ji1udd/Hermes-Lite2/compact-trx/TX_RX_Filter/docs/filter_test_board.JPG

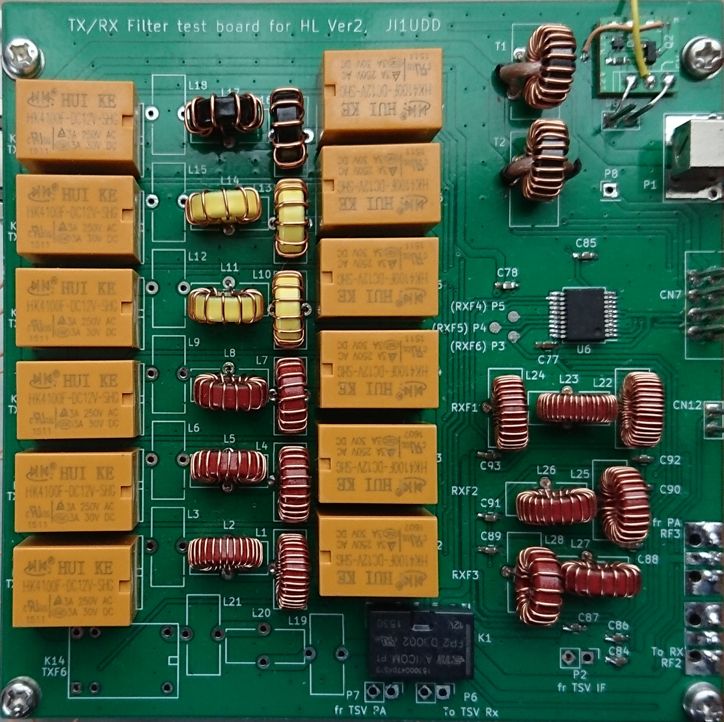
compact-trx/TX_RX_Filter/docs/filter_test_board.JPG
