ji1udd/Hermes-Lite2/compact-trx/TX_RX_Filter/docs/Filter_Setting.jpg

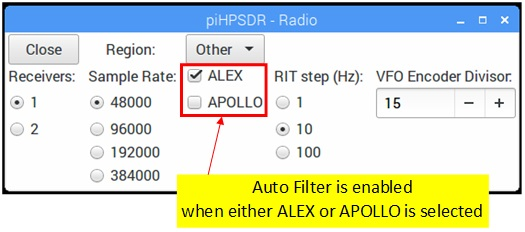
compact-trx/TX_RX_Filter/docs/Filter_Setting.jpg
