ji1udd/Hermes-Lite2/V3_Companion/V3_piHPSDR_Setting.pdf

# piHPSDR Setting

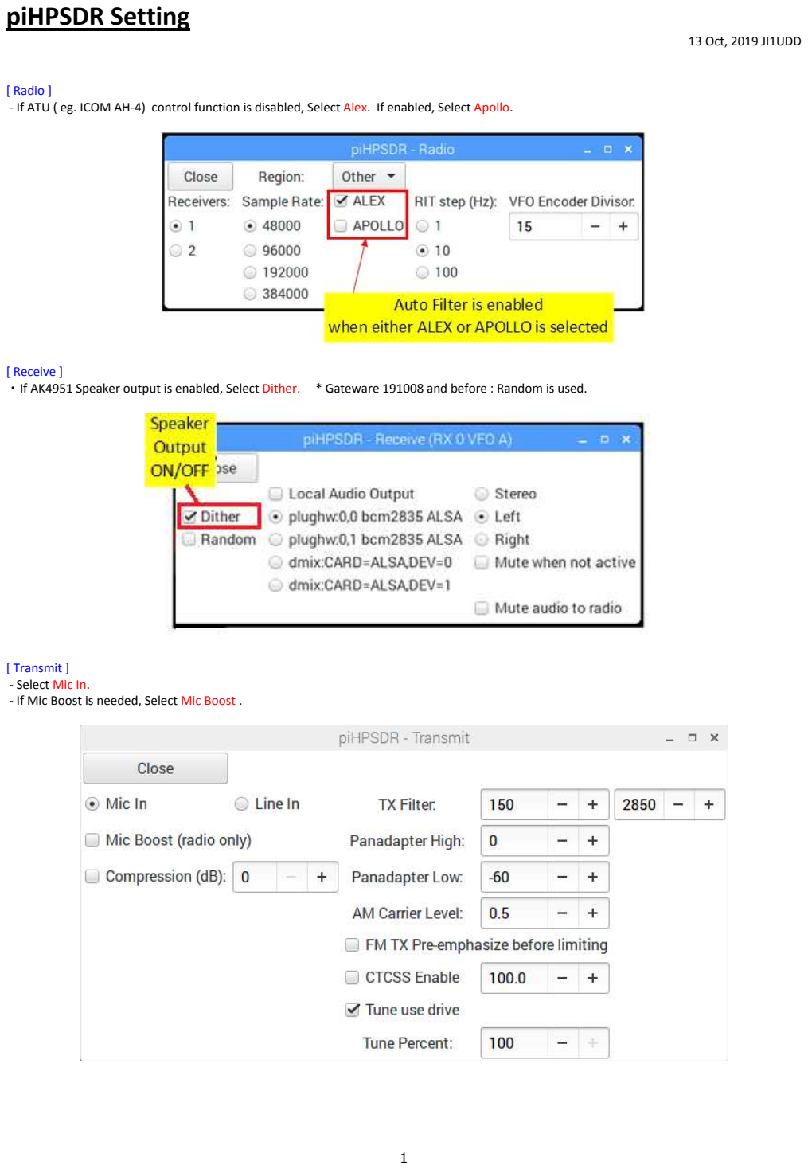
[picture p3: page 1]

### 13 Oct, 2019 JI1UDD

[ Radio ]
- If ATU ( eg. ICOM AH-4) control function is disabled, Select Alex. If enabled, Select Apollo.

[ Receive ]
・If AK4951 Speaker output is enabled, Select Dither. * Gateware 191008 and before : Random is used.

[ Transmit ]
- Select Mic In.
- If Mic Boost is needed, Select Mic Boost .

1

[ PA Calibration ]
- Set 38.8dB ( all band ).

[ CW ]

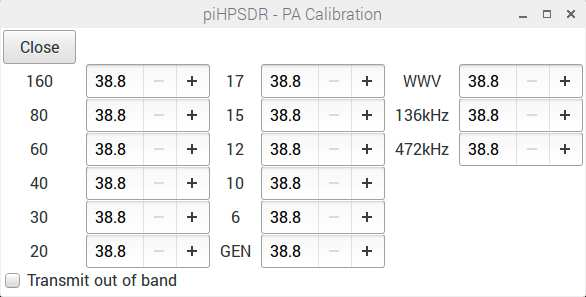
[picture p4: figure]

・Refer to https://github.com/ji1udd/Hermes-Lite/blob/6M/audiocodec/docs/Keyer_Sequece_and_setting.pdf

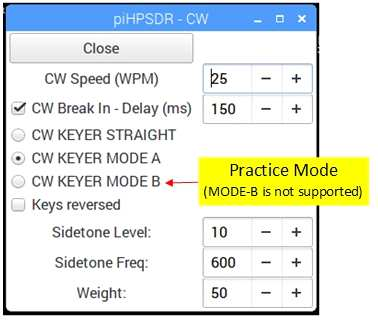
[picture p5: figure]

2

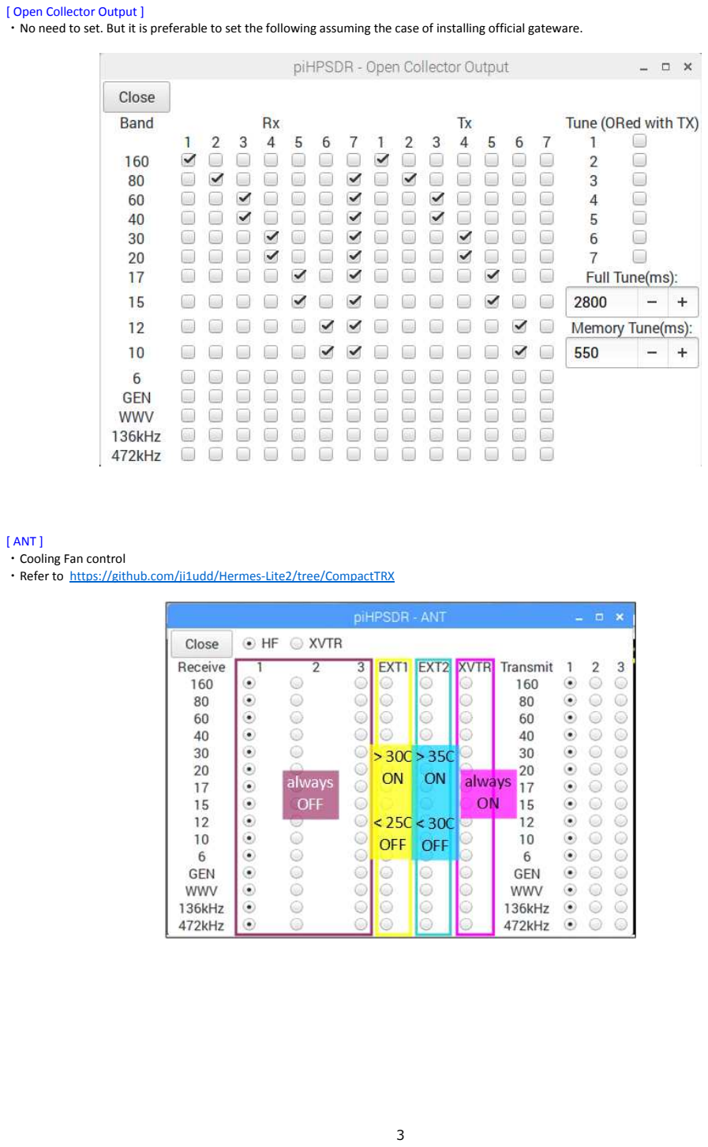
[picture p6: page 3]

[ Open Collector Output ]
・No need to set. But it is preferable to set the following assuming the case of installing official gateware.

[ ANT ]
・Cooling Fan control
・Refer to https://github.com/ji1udd/Hermes-Lite2/tree/CompactTRX

3
