ji1udd/Hermes-Lite2/V3_Companion/V3_PowerSDR_Setting.pdf

# PowerSDR Setting

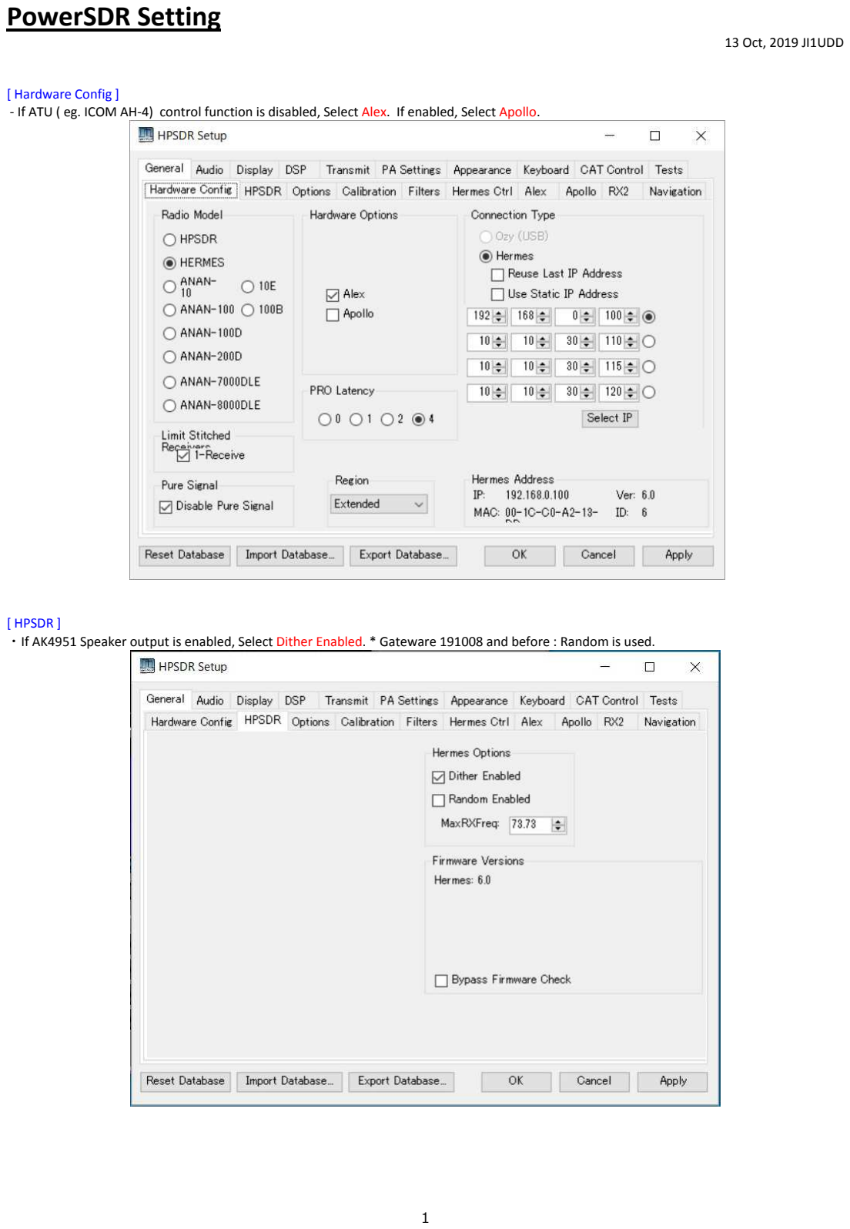
[picture p7: page 1]

### 13 Oct, 2019 JI1UDD

[ Hardware Config ]
- If ATU ( eg. ICOM AH-4) control function is disabled, Select Alex. If enabled, Select Apollo.

[ HPSDR ]
・If AK4951 Speaker output is enabled, Select Dither Enabled. * Gateware 191008 and before : Random is used.

1

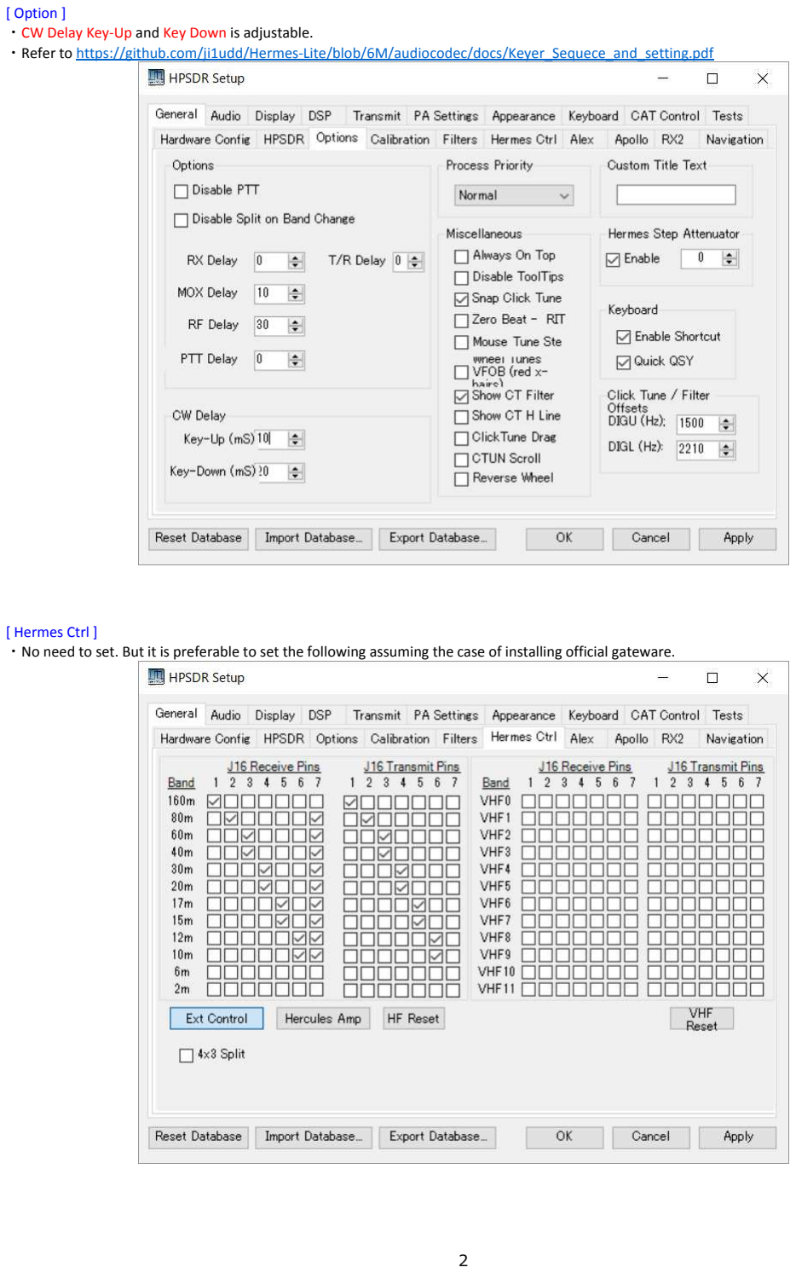
[picture p8: page 2]

[ Option ]
・CW Delay Key-Up and Key Down is adjustable.
・Refer to https://github.com/ji1udd/Hermes-Lite/blob/6M/audiocodec/docs/Keyer_Sequece_and_setting.pdf

[ Hermes Ctrl ]
・No need to set. But it is preferable to set the following assuming the case of installing official gateware.

2

[ Alex - HPF/LPF ]
・If Auto filter mode is enabled (recommended), Select Firmware.

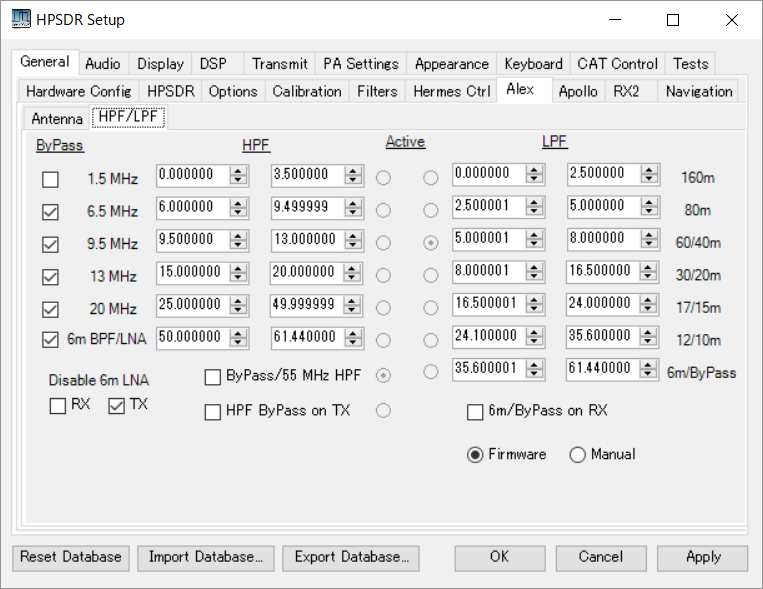
[picture p9: figure]

・If Manual filter mode is enabled, Select Manual and Set HPF and LPF freq.

3

[ Apollo ]
- If Apollo is selected on Hardware Config tab, Select Enable Filters.
- If ATU ( eg. ICOM AH-4) control function is enabled, Select Enable Tuner. Refer to https://github.com/ji1udd/Hermes-Lite2/tree/ATU

[ DSP - CW ]

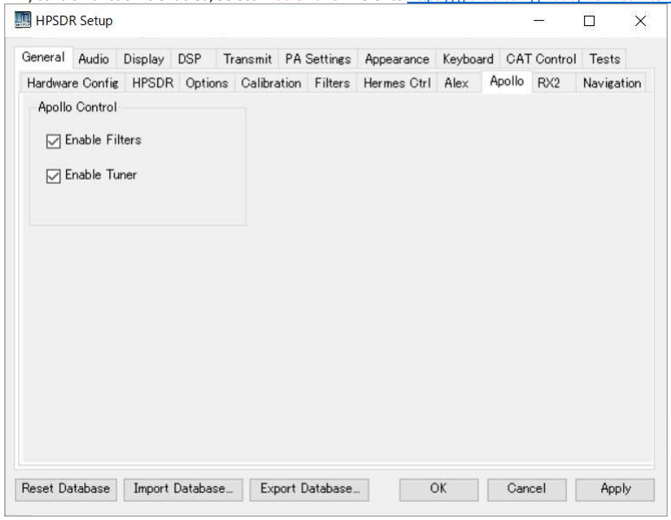
[picture p10: figure]

- Select Radio on Primary pull-down menu.
- Refer to https://github.com/ji1udd/Hermes-Lite/blob/6M/audiocodec/docs/Keyer_Sequece_and_setting.pdf

4

[ Transmit ]
- Select Mic In.
- If Mic Boost is needed, Select 20dB Mic Boost .

[ PA Settings ]

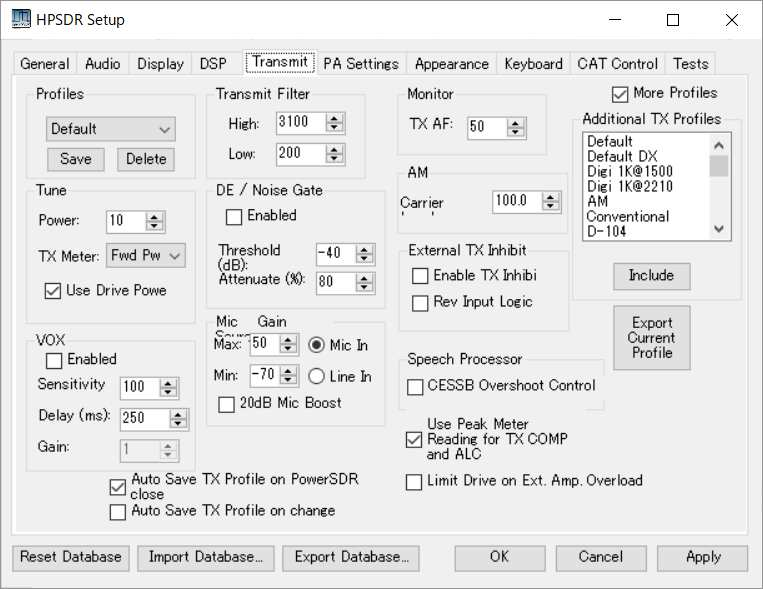
[picture p11: figure]

- Set 38.8dB ( all band ).

5
