ji1udd/Hermes-Lite2/CTRX_HL2b5/docs/HL2b5_modification_for_ComboBoard.pdf

18 Mar. 2018 JI1UDD
1. For Power Supply control

1-1. Remove J24 to enable to be controlled by PIC12F1822. Note: If forget this, PIC will be broken soon.

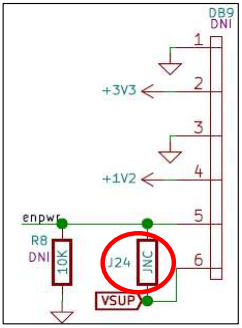
[picture p12: figure]
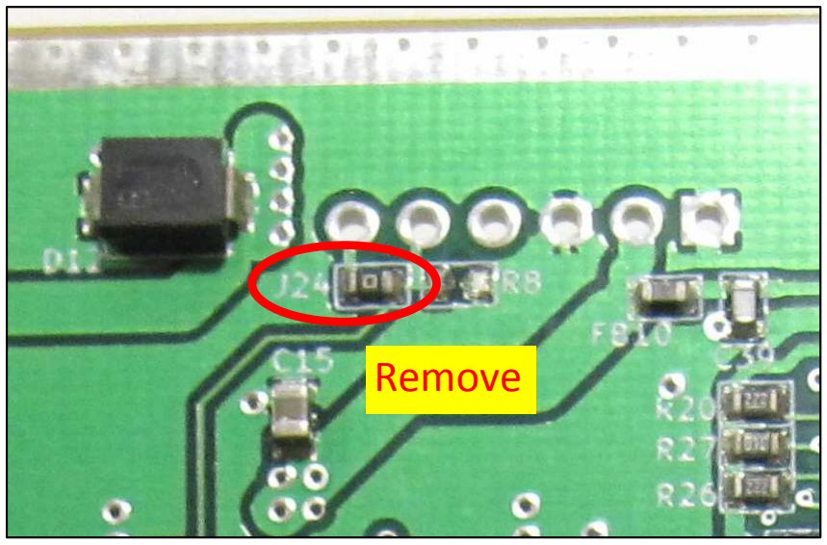
[picture p13: figure]
Remove

1-2. Install R9 to disable VPA reliably during power off.

# HL2b5 Modification for Combo board

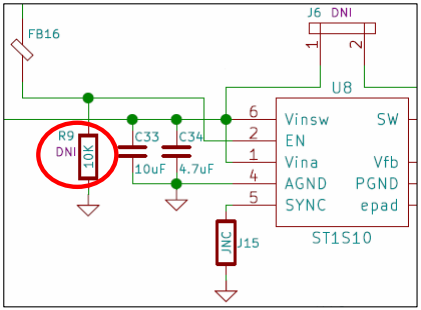
[picture p14: figure]
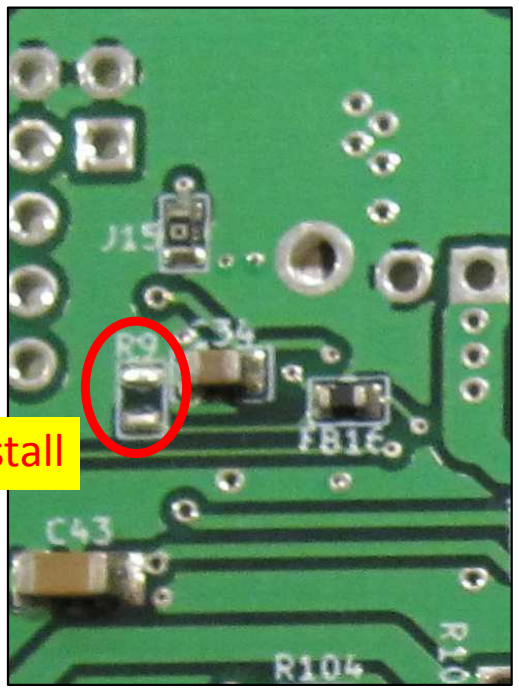
[picture p15: figure]

Install

2. For Audio Codec

Supply 3.3V to VLVDS (AK4951 IO power supply) instead of 2.5V.
2-1. Remove FB28
2-2. Install the removed Ferrite Bead between DB1-7pin and R72 (3.3V side).

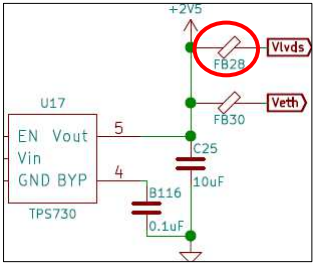
[picture p16: figure]
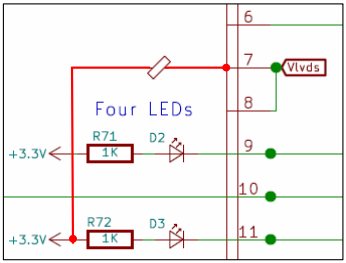
[picture p17: figure]
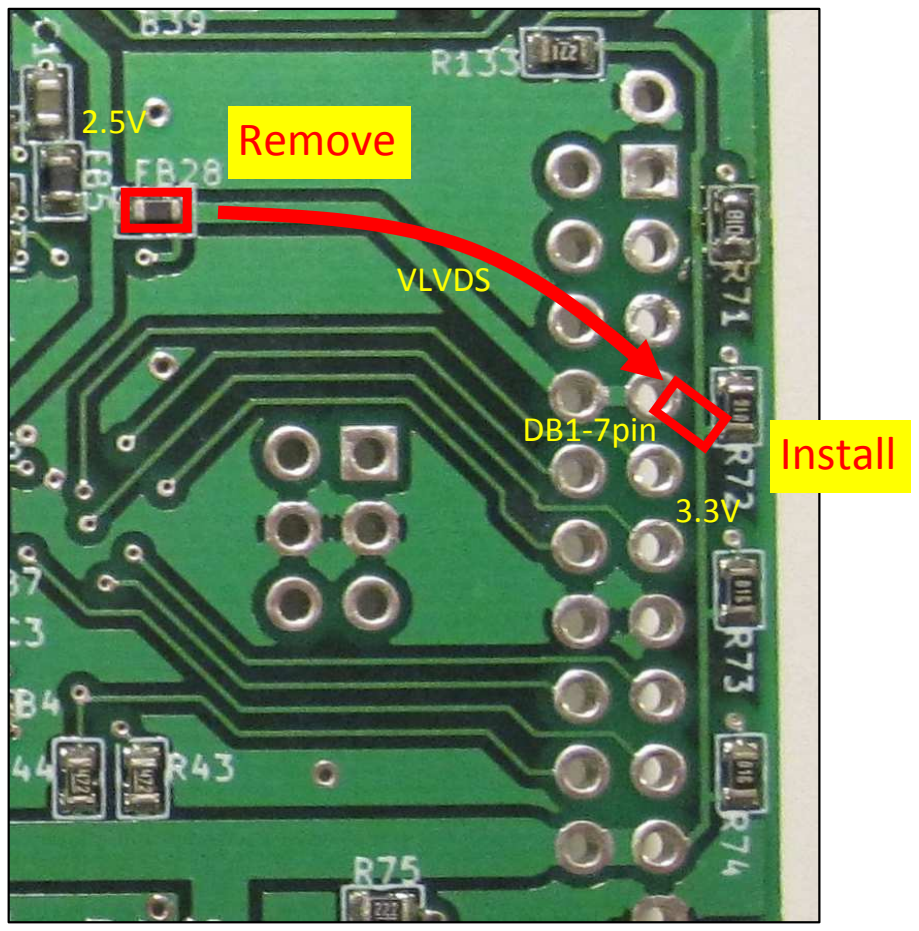
[picture p18: figure]
Remove; Install; VLVDS; DB1-7pin

Appendix

- Install R117, R118 and R119 to disable the function reliably

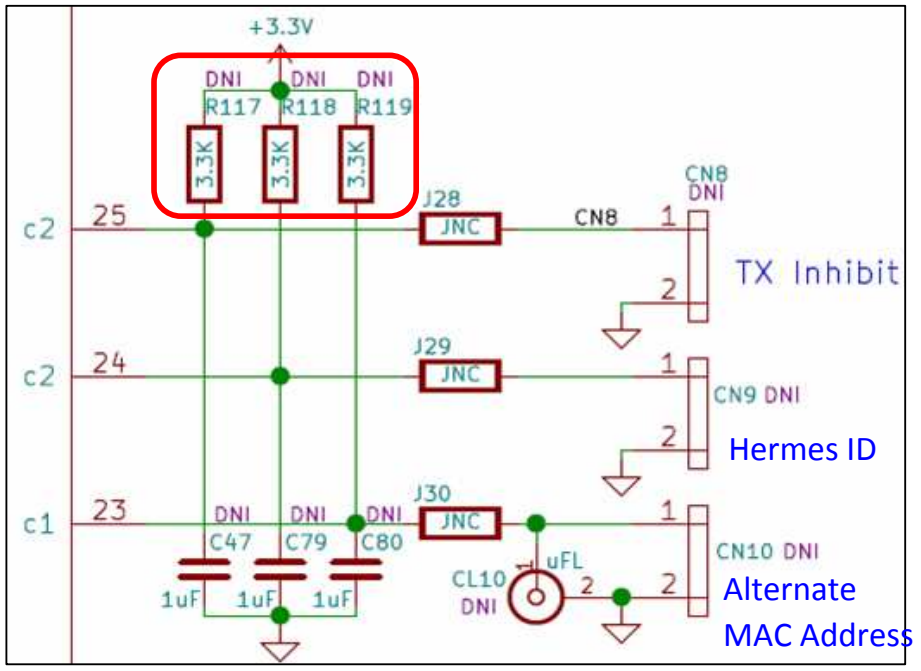
[picture p19: figure]
Hermes ID; Alternate; MAC Address
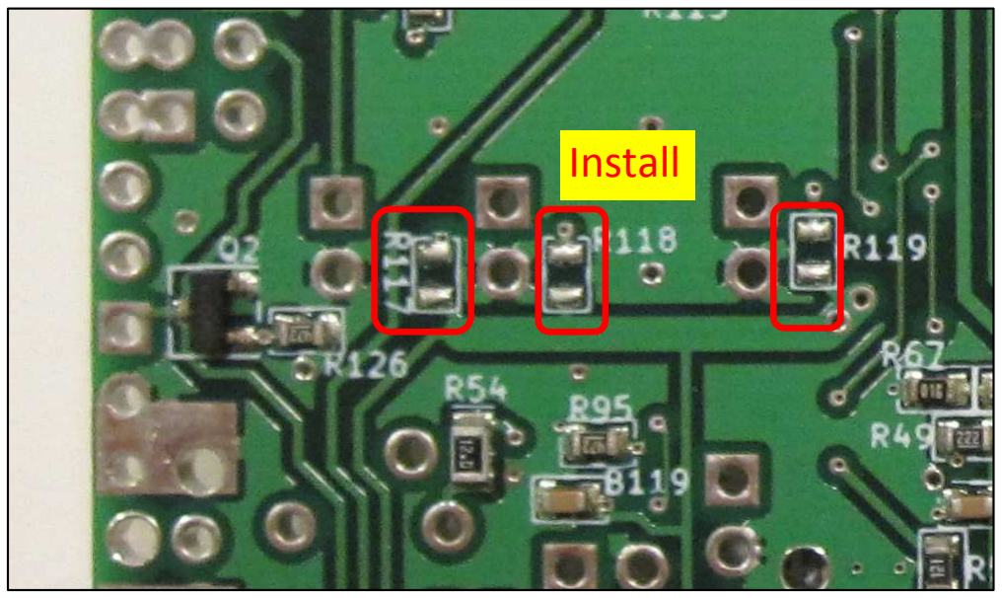
[picture p20: figure]
Install
