ji1udd/Hermes-Lite2/compact-trx/piHPSDR/docs/Temperature_Ammeter_Mod_171217.pdf

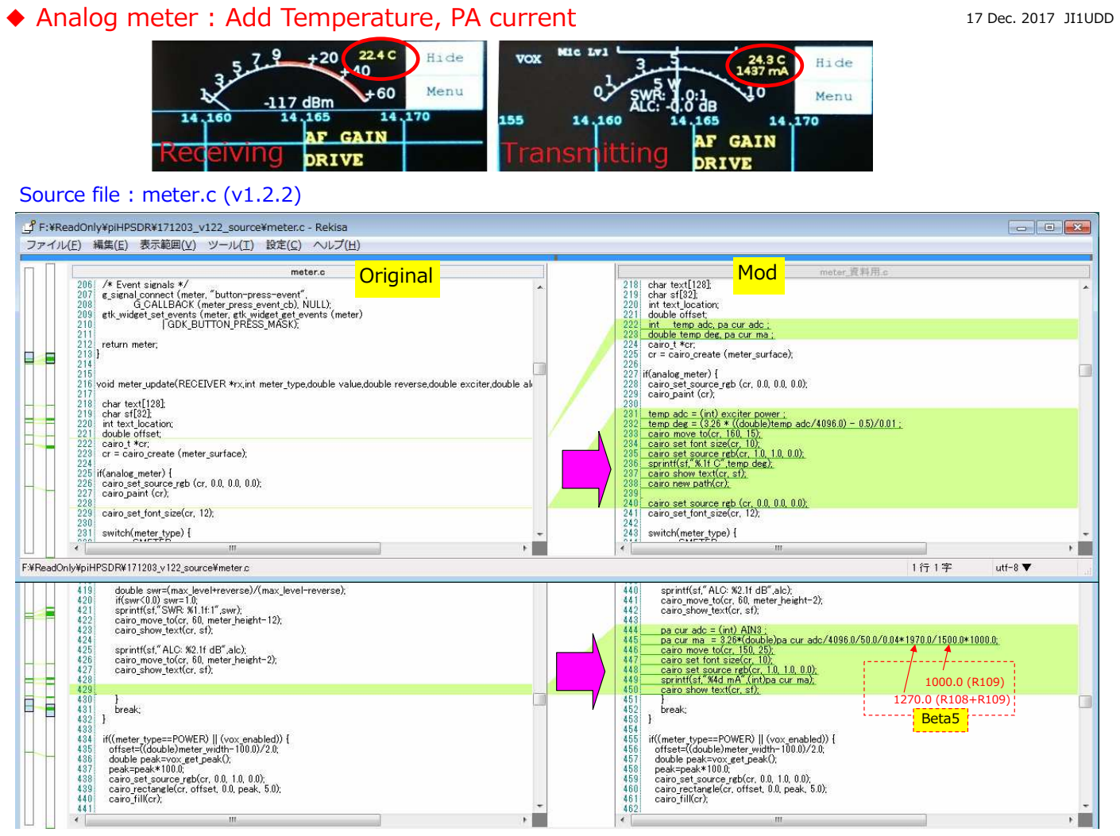
[picture p21: page 1]

◆ Analog meter : Add Temperature, PA current | 17 Dec. 2017 JI1UDD

Source file : meter.c (v1.2.2)

Original | Mod

1000.0 (R109)
1270.0 (R108+R109)
Beta5
