ji1udd/Hermes-Lite2/compact-trx/piHPSDR/docs/FWD_Analog_Meter_Mod_171210.pdf

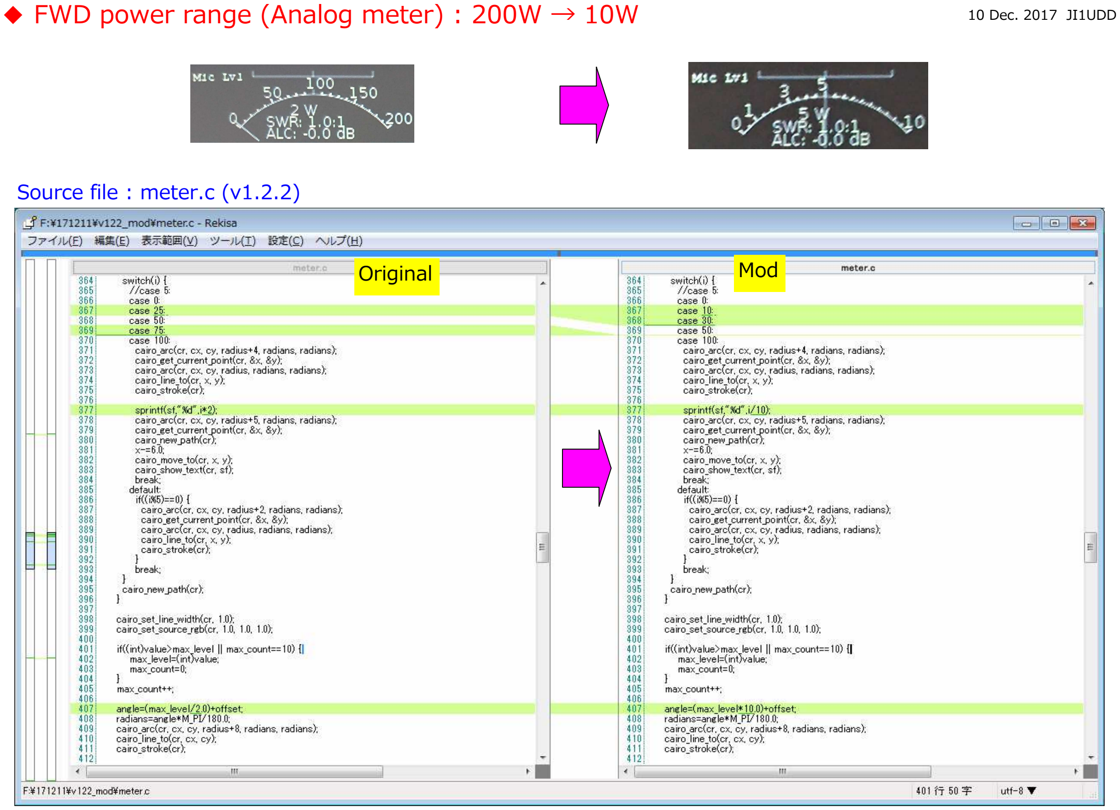
[picture p22: page 1]

◆ FWD power range (Analog meter) : 200W → 10W | 10 Dec. 2017 JI1UDD

Source file : meter.c (v1.2.2)

Original | Mod
