ji1udd/Hermes-Lite2/compact-trx/piHPSDR/docs/Slider_RxGAIN_Mod_171210.pdf

◆ Slider function : Attenuator → RX GAIN | 10 Dec. 2017 JI1UDD

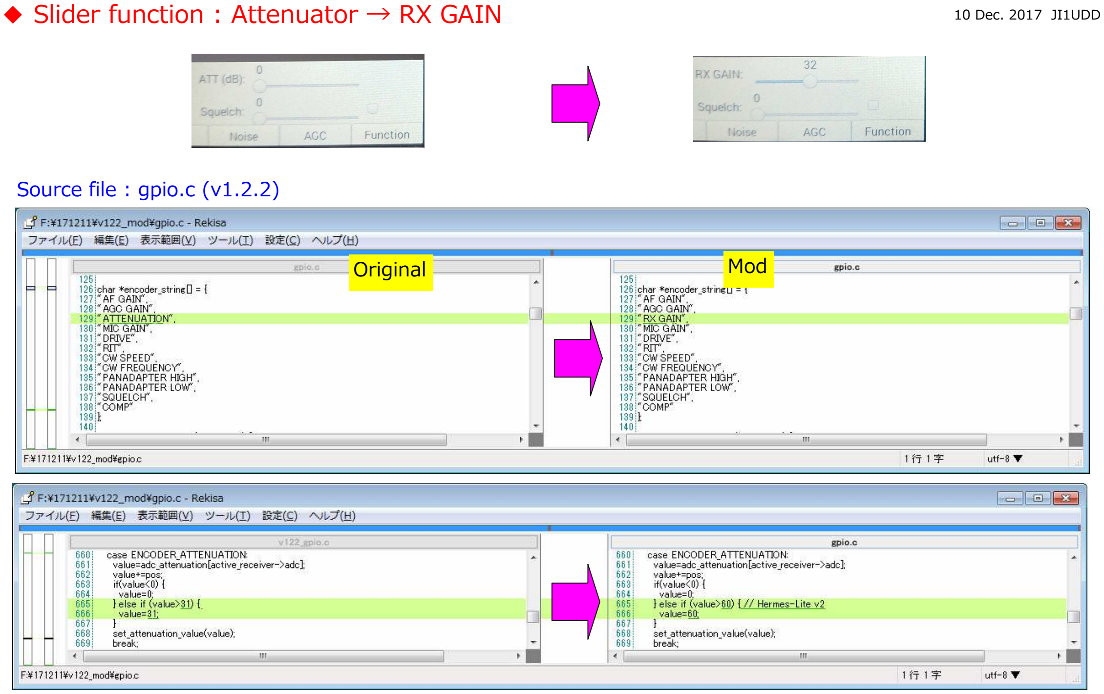
[picture p23: page 1]

Source file : gpio.c (v1.2.2)

Original | Mod

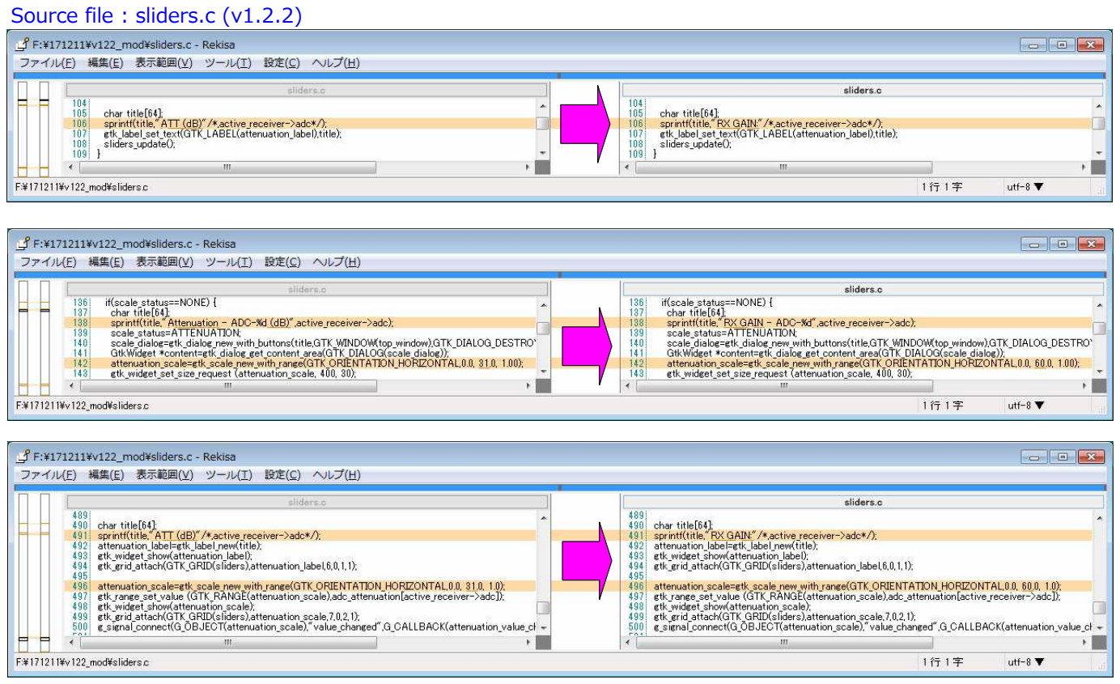
[picture p24: page 2]

Source file : sliders.c (v1.2.2)

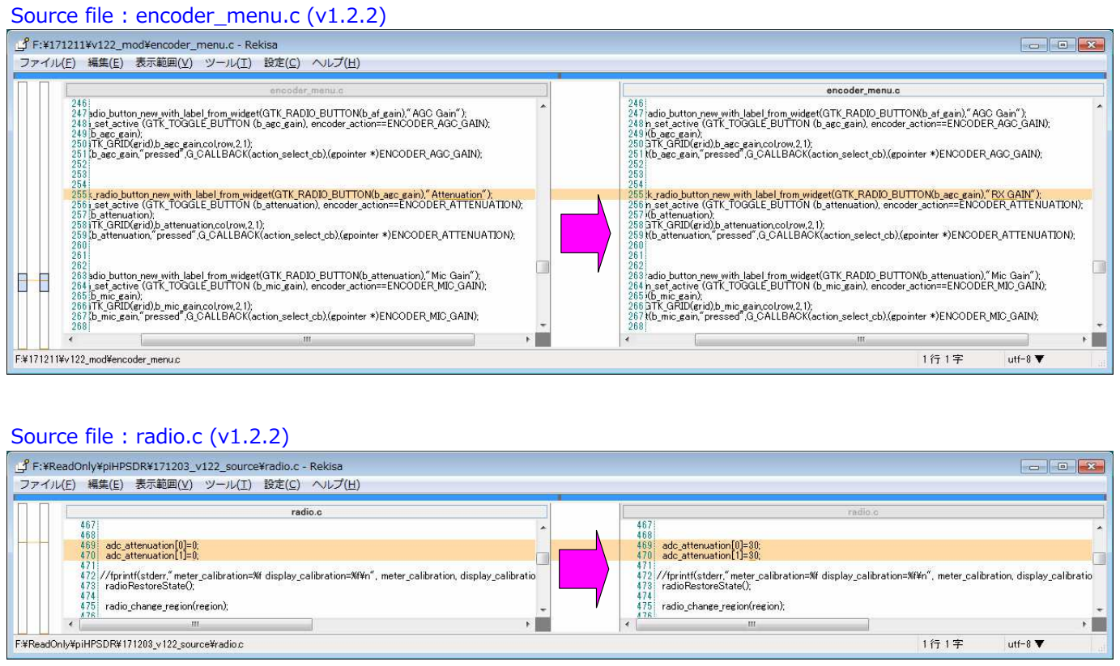
[picture p25: page 3]

Source file : encoder_menu.c (v1.2.2)

Source file : radio.c (v1.2.2)

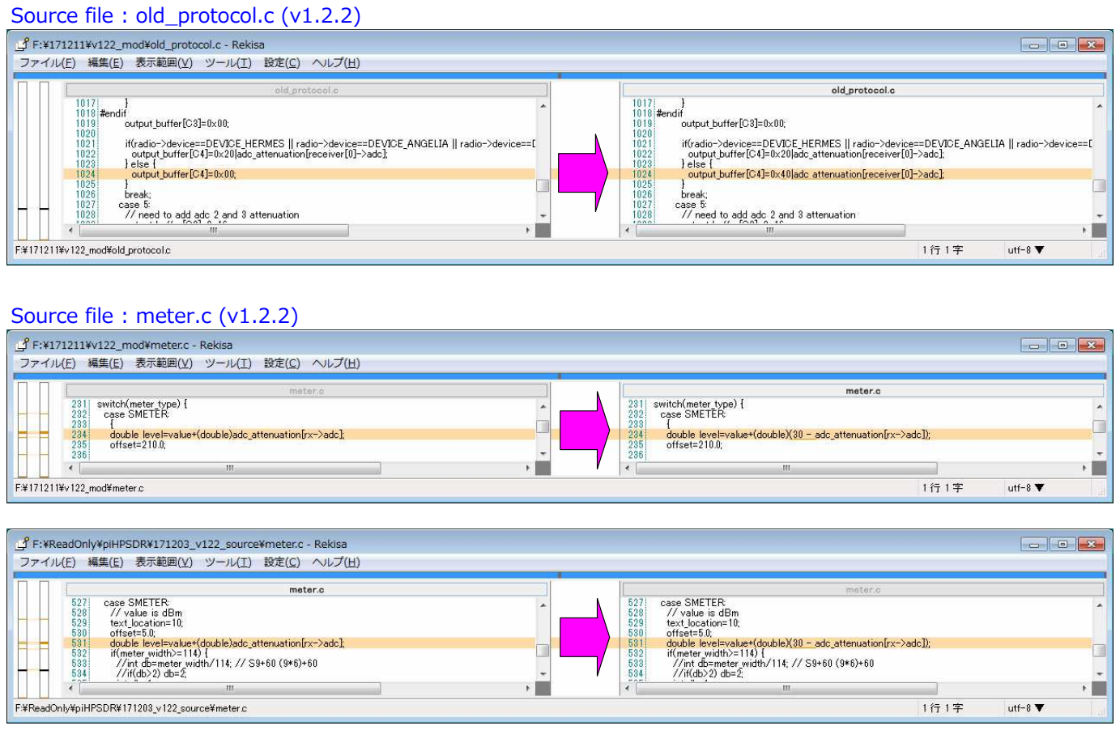
[picture p26: page 4]

Source file : old_protocol.c (v1.2.2)

Source file : meter.c (v1.2.2)

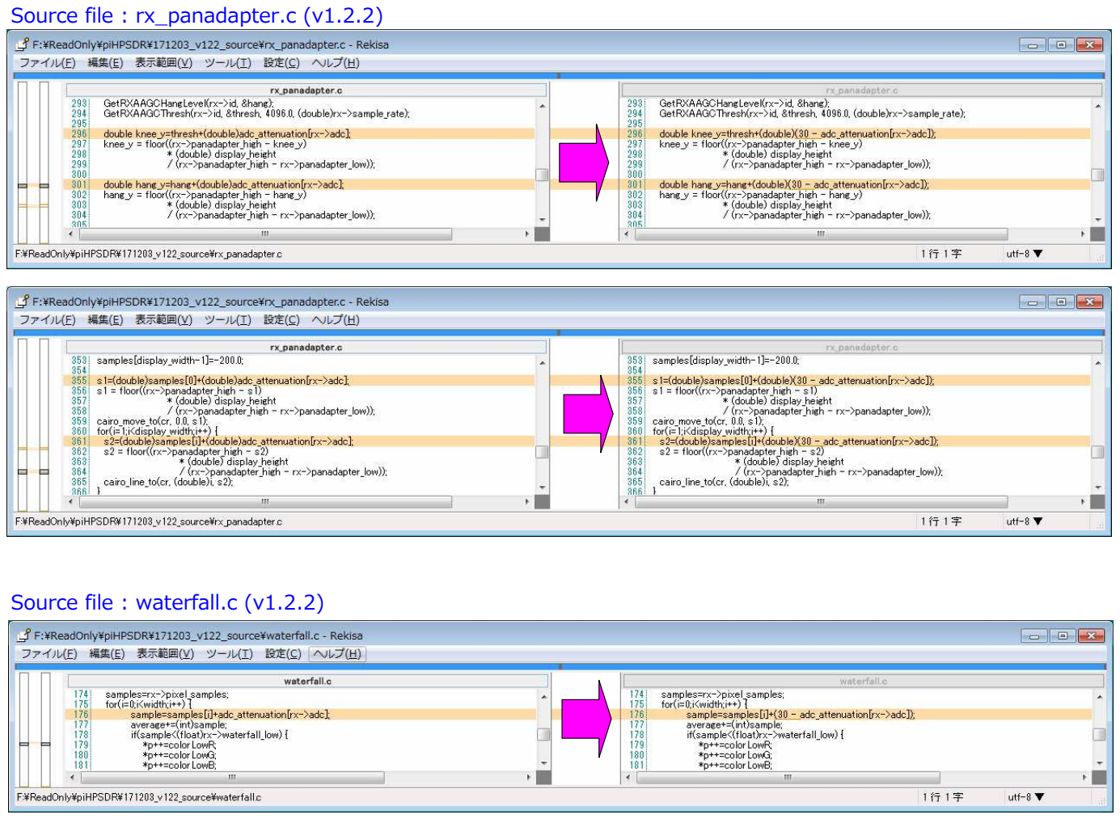
[picture p27: page 5]

Source file : rx_panadapter.c (v1.2.2)

Source file : waterfall.c (v1.2.2)
