ji1udd/Hermes-Lite2/compact-trx/IF_board/docs/IF_board.JPG

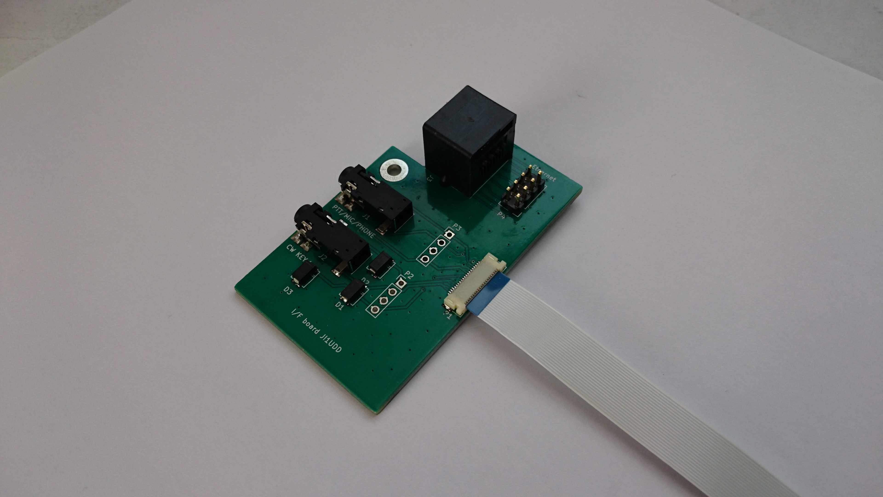
compact-trx/IF_board/docs/IF_board.JPG
