ji1udd/Hermes-Lite2/compact-trx/Keyer_AK4951/docs/Headset_modification.jpg

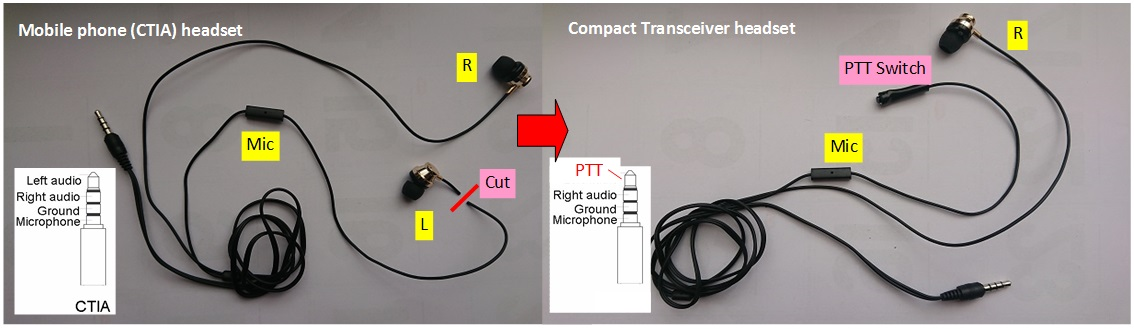
compact-trx/Keyer_AK4951/docs/Headset_modification.jpg
