ji1udd/Hermes-Lite2/compact-trx/Keyer_AK4951/docs/HLv2Beta3_with_KeyerIF_AK4951_board.JPG

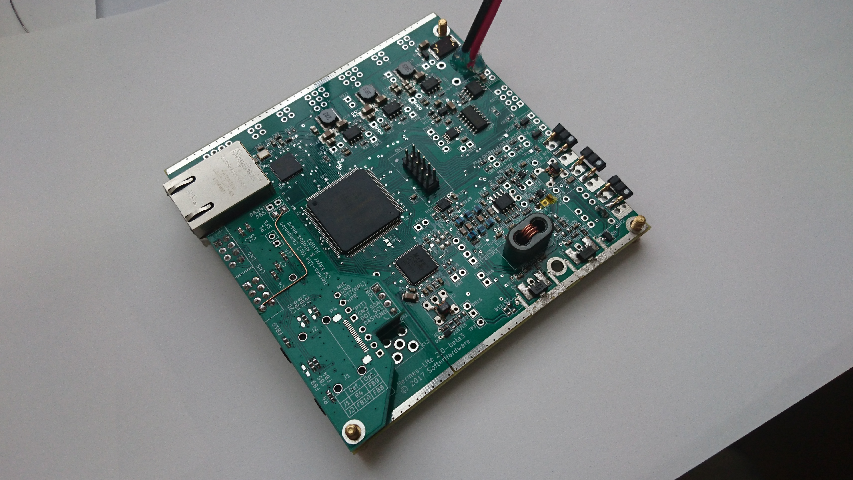
compact-trx/Keyer_AK4951/docs/HLv2Beta3_with_KeyerIF_AK4951_board.JPG
