ji1udd/Hermes-Lite2/compact-trx/Keyer_AK4951/docs/Speaker_Setting.jpg

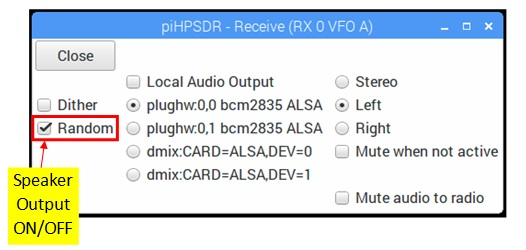
compact-trx/Keyer_AK4951/docs/Speaker_Setting.jpg
