ji1udd/Hermes-Lite2/compact-trx/piHPSDR/docs/FWD_meter_mod.jpg

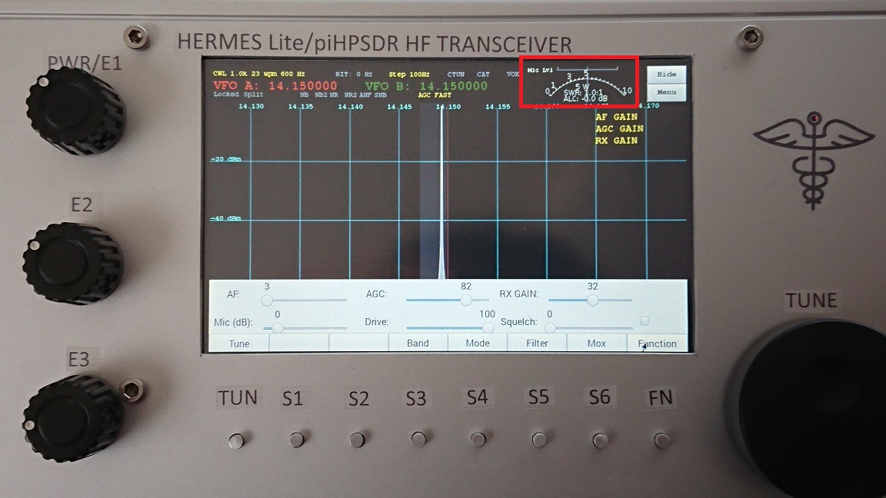
compact-trx/piHPSDR/docs/FWD_meter_mod.jpg
