ji1udd/Hermes-Lite2/compact-trx/piHPSDR/docs/RX_GAIN_mod.jpg

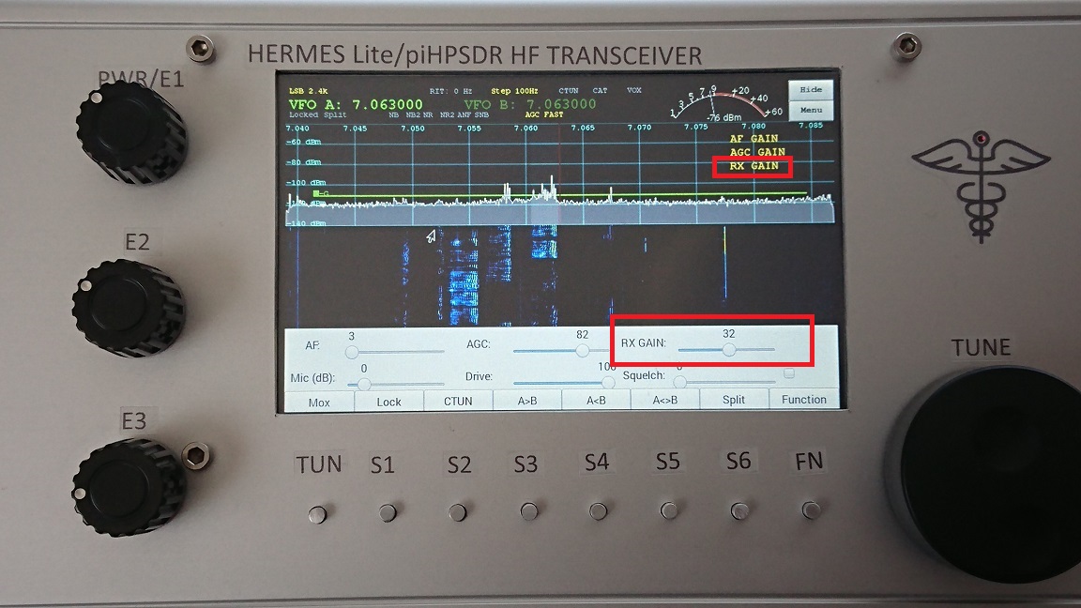
compact-trx/piHPSDR/docs/RX_GAIN_mod.jpg
