ji1udd/Hermes-Lite2/compact-trx/piHPSDR/docs/Temperature_Ammeter_Mod.jpg

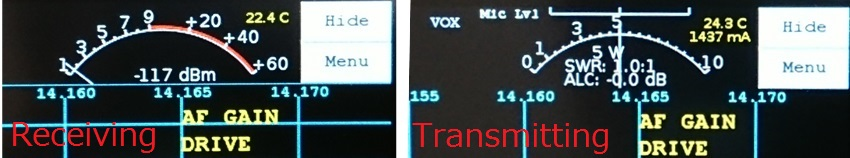
compact-trx/piHPSDR/docs/Temperature_Ammeter_Mod.jpg
