ji1udd/Hermes-Lite2/compact-trx/powercontrol/docs/Add-on-PMOS-switch.png

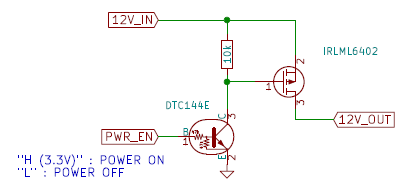
compact-trx/powercontrol/docs/Add-on-PMOS-switch.png
