ji1udd/Hermes-Lite2/compact-trx/powercontrol/docs/ATU_Setting.jpg

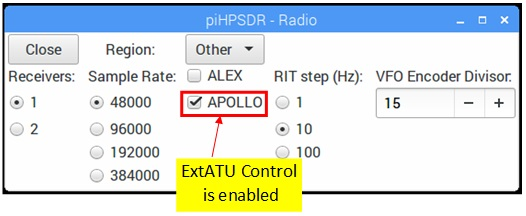
compact-trx/powercontrol/docs/ATU_Setting.jpg
