ji1udd/Hermes-Lite2/compact-trx/powercontrol/docs/ATU_timing_chart.jpg

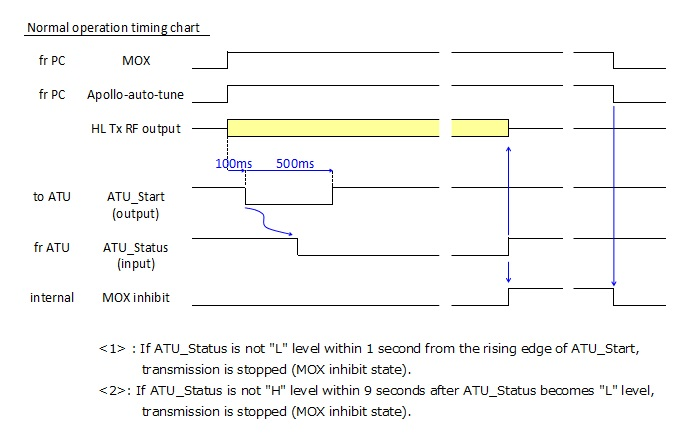
compact-trx/powercontrol/docs/ATU_timing_chart.jpg
