ji1udd/Hermes-Lite2/compact-trx/powercontrol/docs/compact-trx-photos.jpg

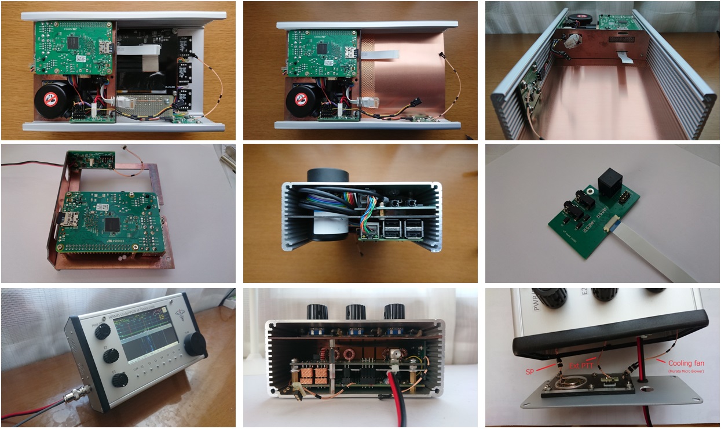
compact-trx/powercontrol/docs/compact-trx-photos.jpg
