ji1udd/Hermes-Lite2/compact-trx/powercontrol/docs/compact-trx.JPG

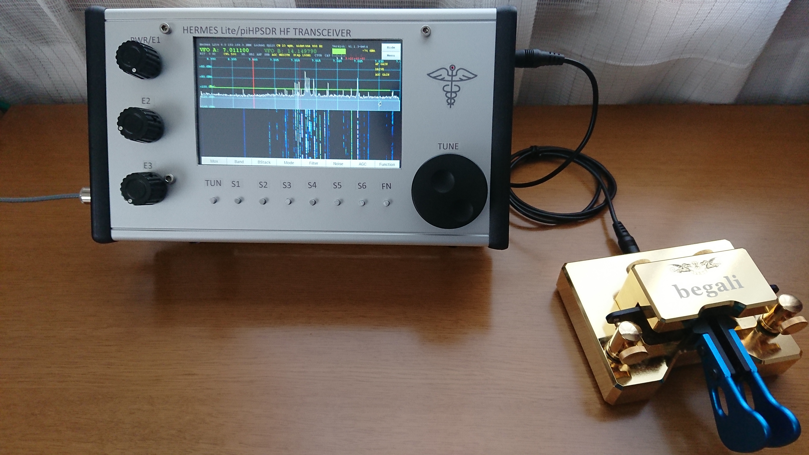
compact-trx/powercontrol/docs/compact-trx.JPG
