ji1udd/Hermes-Lite2/compact-trx/powercontrol/docs/ExtAMP-ATU-Interface.jpg

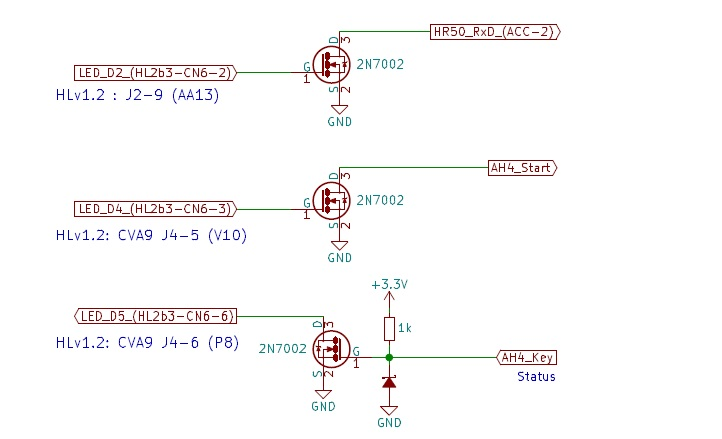
compact-trx/powercontrol/docs/ExtAMP-ATU-Interface.jpg
