ji1udd/Hermes-Lite2/compact-trx/powercontrol/docs/Fan_Control_setting.jpg

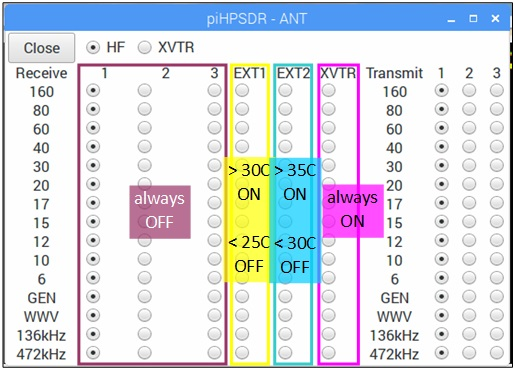
compact-trx/powercontrol/docs/Fan_Control_setting.jpg
