ji1udd/Hermes-Lite2/compact-trx/powercontrol/docs/PowerControlboard.jpg

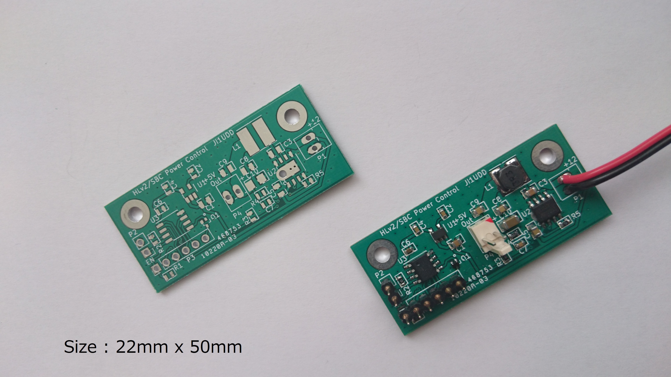
compact-trx/powercontrol/docs/PowerControlboard.jpg
