ji1udd/Hermes-Lite2/CTRX_HL2b5/docs/LEDs_function.jpg

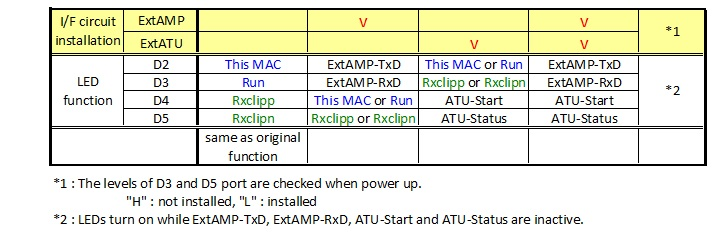
CTRX_HL2b5/docs/LEDs_function.jpg
