ji1udd/Hermes-Lite2/compact-trx/IF_board/docs/BOM_IF_board.pdf

Designator | Qty. | Value/Description | Package | Manufacture | Manufacturer P/N | Supplier | Supplier P/N
D1, D2, D3 | 3 | TVS Diode
J1, J2 | 2 | 3.5mm Jack 4-contact | - | CUI | SJ-43514-SMT
J3 | 1 | RJ45 | - | WURTH
P1 | 1 | CONN FFC 20POS 0.50MM R/A Non-ZIF | - | Kyocera/AVX | 6222Series 086222020101800+ | DigiKey | 1253-1779-1-ND
P2, P3 | 2 | Pin header 2.54mm 4pin | -
Designator | Qty. | Value/Description | Package | Manufacture | Manufacturer P/N | Supplier | Supplier P/N
- | 1 | CABLE FFC 20POS 0.50MM 4" | - | Molex | 151660211 | DigiKey | WM11307-ND
