ji1udd/Hermes-Lite2/CTRX_HL2b5/docs/IF_board_assemble_option.pdf

Assembly options
option # | I/F board | Cable type | Audio codec board | IF board
Install | Don't care (not used) | Install | Don't care (not used)
1 | No use | - | J1, J2 | P2, P3, P4 | - | -
2 | Use | Shielded cable | P2, P3 | J1, J2, P4 | J1, J2, P2, P3 | P1
3 | Use | FFC | P4 | J1, J2, P2, P3 | J1, J2, P1 | P2, P3
