ji1udd/Hermes-Lite2/CTRX_HL2b5/docs/Installation_Guide_codec_HL2b5_or_later.pdf

### Installation guide "CW Keyer I/F and AK4951 audio codec board" for HL2b5 or later

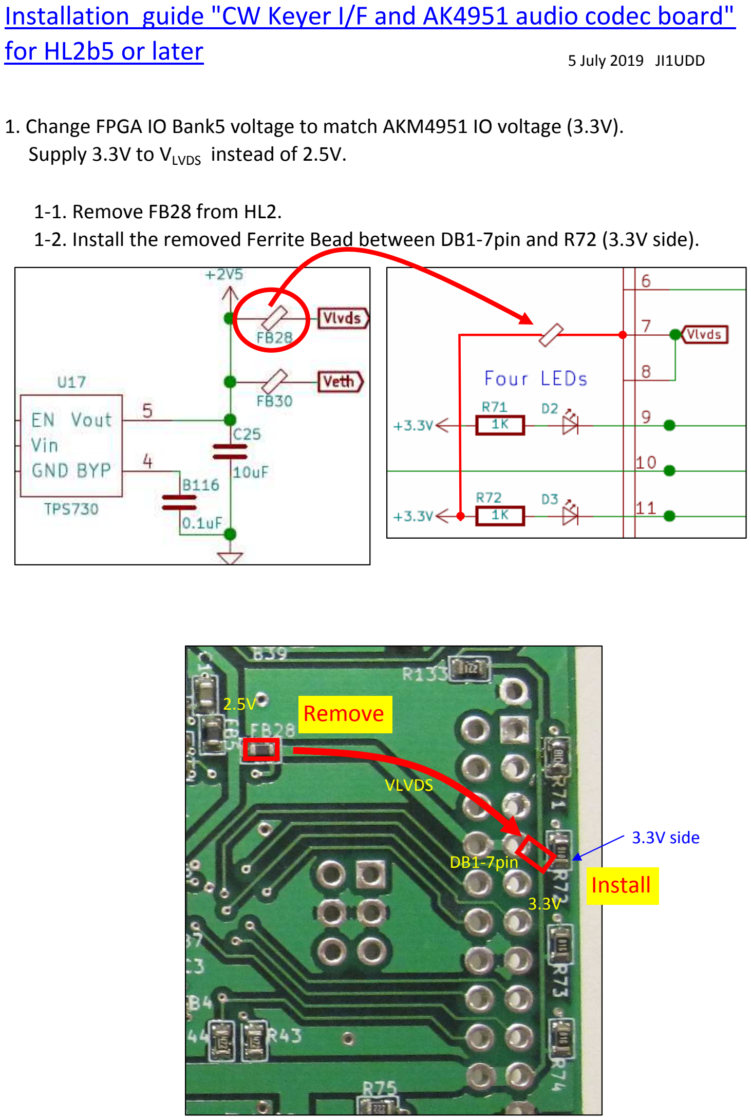
[picture p48: page 1]

### 5 July 2019 JI1UDD

1. Change FPGA IO Bank5 voltage to match AKM4951 IO voltage (3.3V). Supply 3.3V to VLVDS instead of 2.5V.

1-1. Remove FB28 from HL2.
1-2. Install the removed Ferrite Bead between DB1-7pin and R72 (3.3V side).

Remove

Install

VLVDS

2.5V

3.3V

DB1-7pin

3.3V side

2. Connect "CW Keyer I/F and AK4951 audio codec board" to HL2.

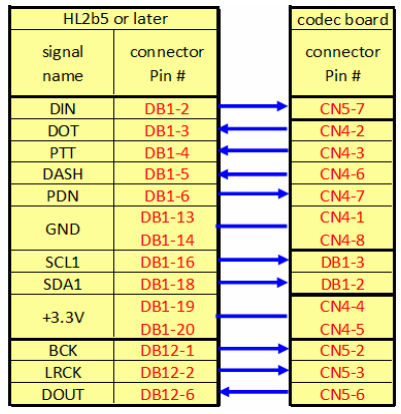
[picture p49: figure]
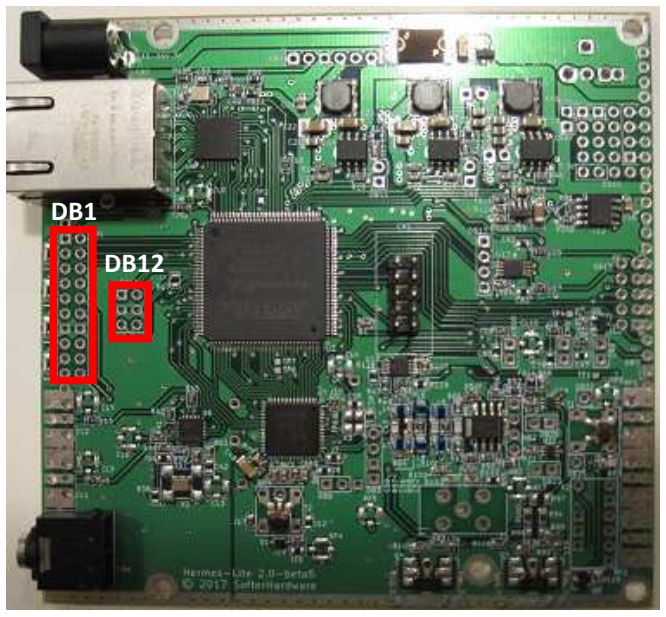
[picture p50: figure]
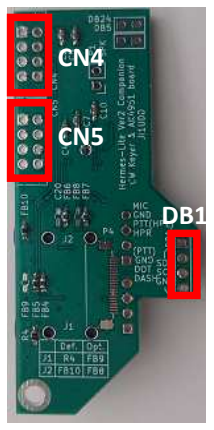
[picture p51: figure]
