ji1udd/Hermes-Lite2/compact-trx/Keyer_AK4951/docs/KeyerIF_AK4951_v2.0.1_PCB_Installation_guide.pdf

Keyer I/F ＆ AK4951 v2.0.1 Installation guide | 17th Aug, 2017 ji1udd

Please read Errata document and do counter measure.

HLv2 modification
1. Remove FB28 and install FB27 ( Vlvds is set to 3.3V ).
2. Remove J14 and install J13 ( CN4-3 and CN4-4 are set to Vlvds).
3. install three 0 ohm resistors at R85, R86 and R87 ( I2S signals are connect to AK4951).

Note
When connectors are assembled, be care of placement torrerance.

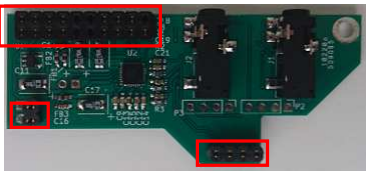
[picture p52: figure]
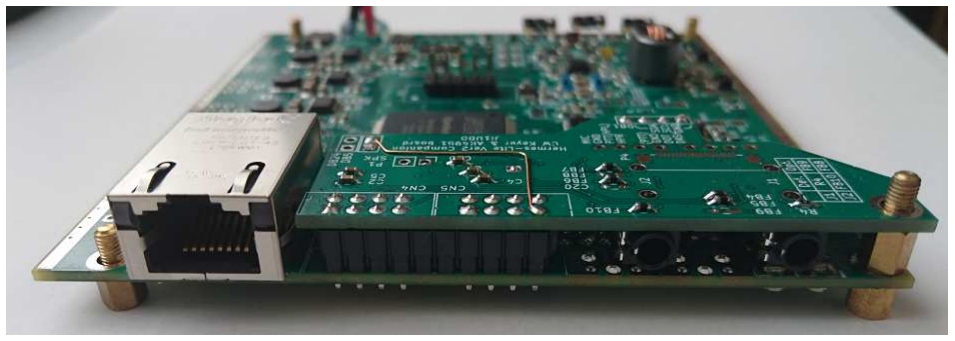
[picture p53: figure]
