ji1udd/Hermes-Lite2/CTRX_HL2b5/docs/PowerSDR_ALEX_ManualFilter_setting_for_Jims_Filter.jpg

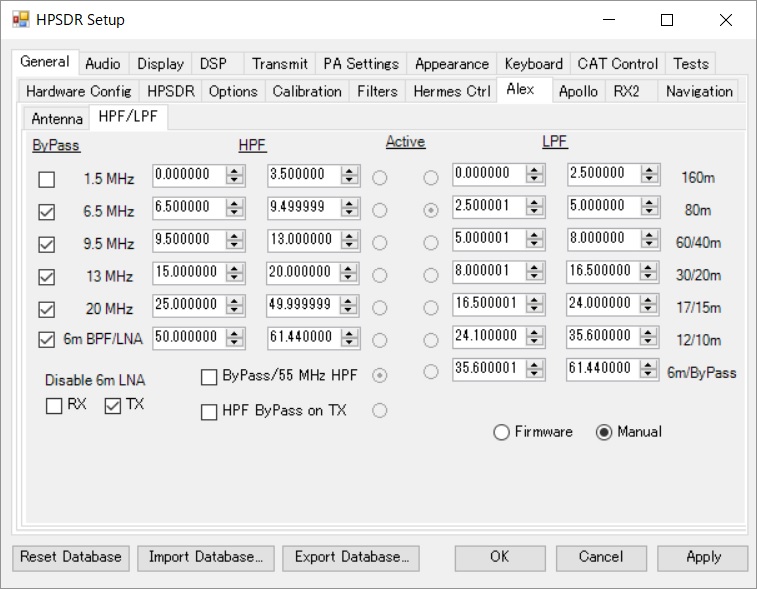
CTRX_HL2b5/docs/PowerSDR_ALEX_ManualFilter_setting_for_Jims_Filter.jpg
