ji1udd/Hermes-Lite2/CTRX_HL2b5/docs/ComboBoardErrata_180406.pdf

### 6 Apr. 2018 JI1UDD

- Wrong MCP23008 footprint

SSOP-20 version is used on Combo board schematic. But SOIC-20 footprint is used on PCB. MCP23008 SOIC-20 is not in the lineup, but SOIC-18 is in the lineup.
Use MCP23008-E/SO (SOIC-18), place it close to the 1pin side.

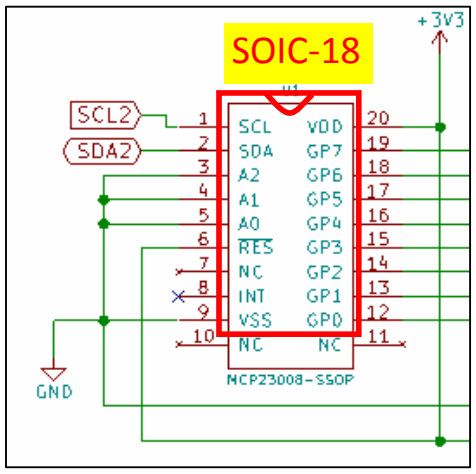
[picture p55: figure]
SOIC-18
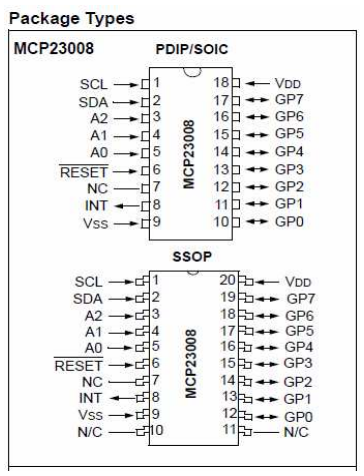
[picture p56: figure]

cf.

# Combo board errata

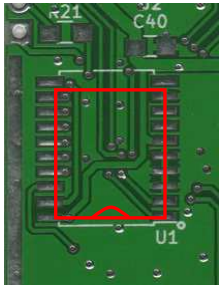
[picture p57: figure]
