ji1udd/Hermes-Lite2/compact-trx/TX_RX_Filter/docs/Tx_Rx_Filter_v1.0_PCB_Errata.pdf

Tx Rx Filter v1.0 PCB Errata | 17th Aug, 2017
| 18th Oct, 2017
There is two known errata. | ji1udd
1) Wrong Silk
The silks near RF2 and RF3 are swapped

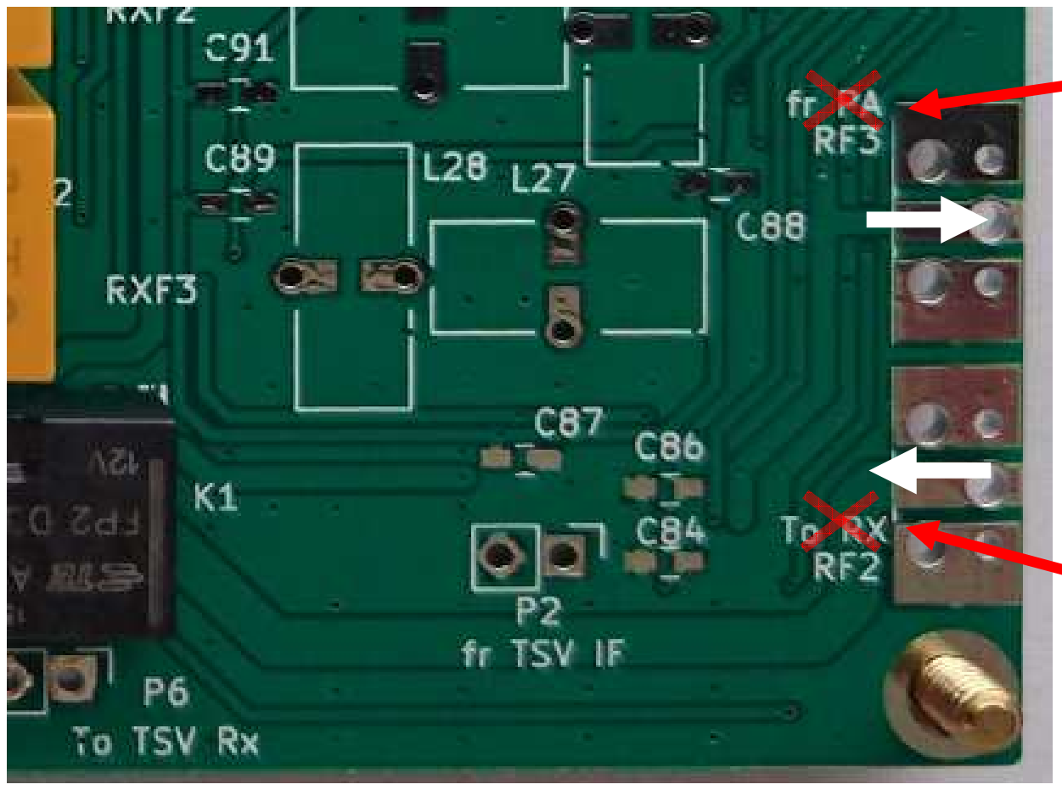
[picture p58: figure]

2) Leakage current
Leakage occurred from DB10-1(+12V source) to +3.3V through Relay driver (TPL 7407) while HL2 turned off. Add high side switch.

RF3

### from HPF to RX (HLv2)

RF2

### from PA (HLv2) to T/R relay

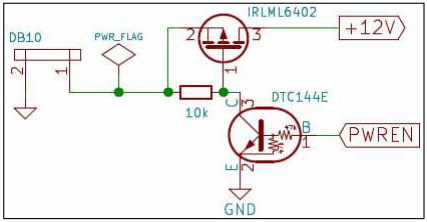
[picture p59: figure]
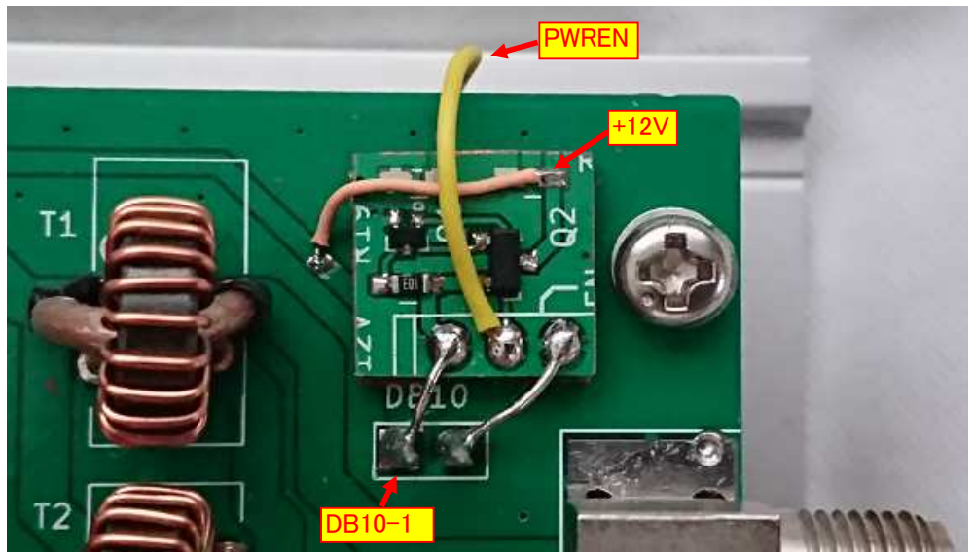
[picture p60: figure]
PWREN
