ji1udd/Hermes-Lite2/compact-trx/Keyer_AK4951/docs/KeyerIF_AK4951_v2.0.1_PCB_Errata.pdf

Keyer I/F ＆ AK4951 v2.0.1 PCB Errata | 17th Aug, 2017 ji1udd

There is two known errata.

1) Wrong Silk
The silks of DB5 and DB24 are swapped

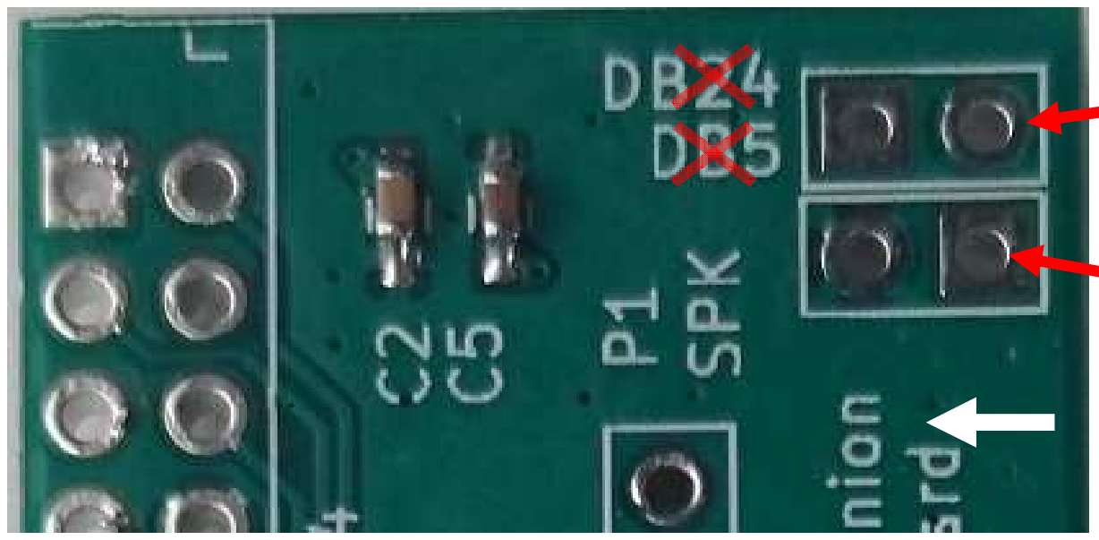
[picture p61: figure]

2) Wrong FPGA signal assignment
FPGA Pin89 (CN5-7) cannot be assigned as Output port.

Counter measure
FPGA Pin76 (DB24-1) is connected to AK4951 Pin11(SDTI) instead.

Step1. Pull CN5-7 contact pin out.

DB5

DB24

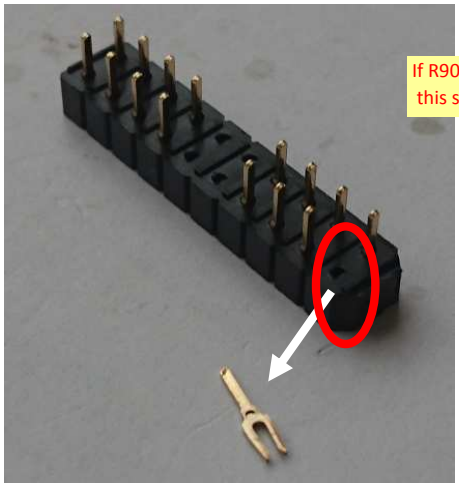
[picture p62: figure]

If R90 is not installed,
this step 1 can be ignored.

Step2. connect DB24-1 with CN5-7

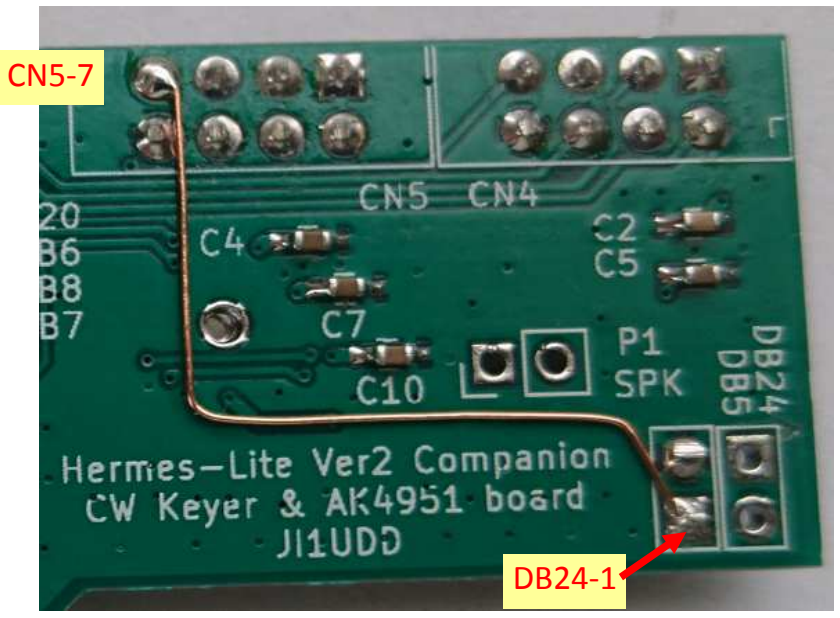
[picture p63: figure]
