ji1udd/Hermes-Lite2/compact-trx/powercontrol/docs/trx_schematic.pdf

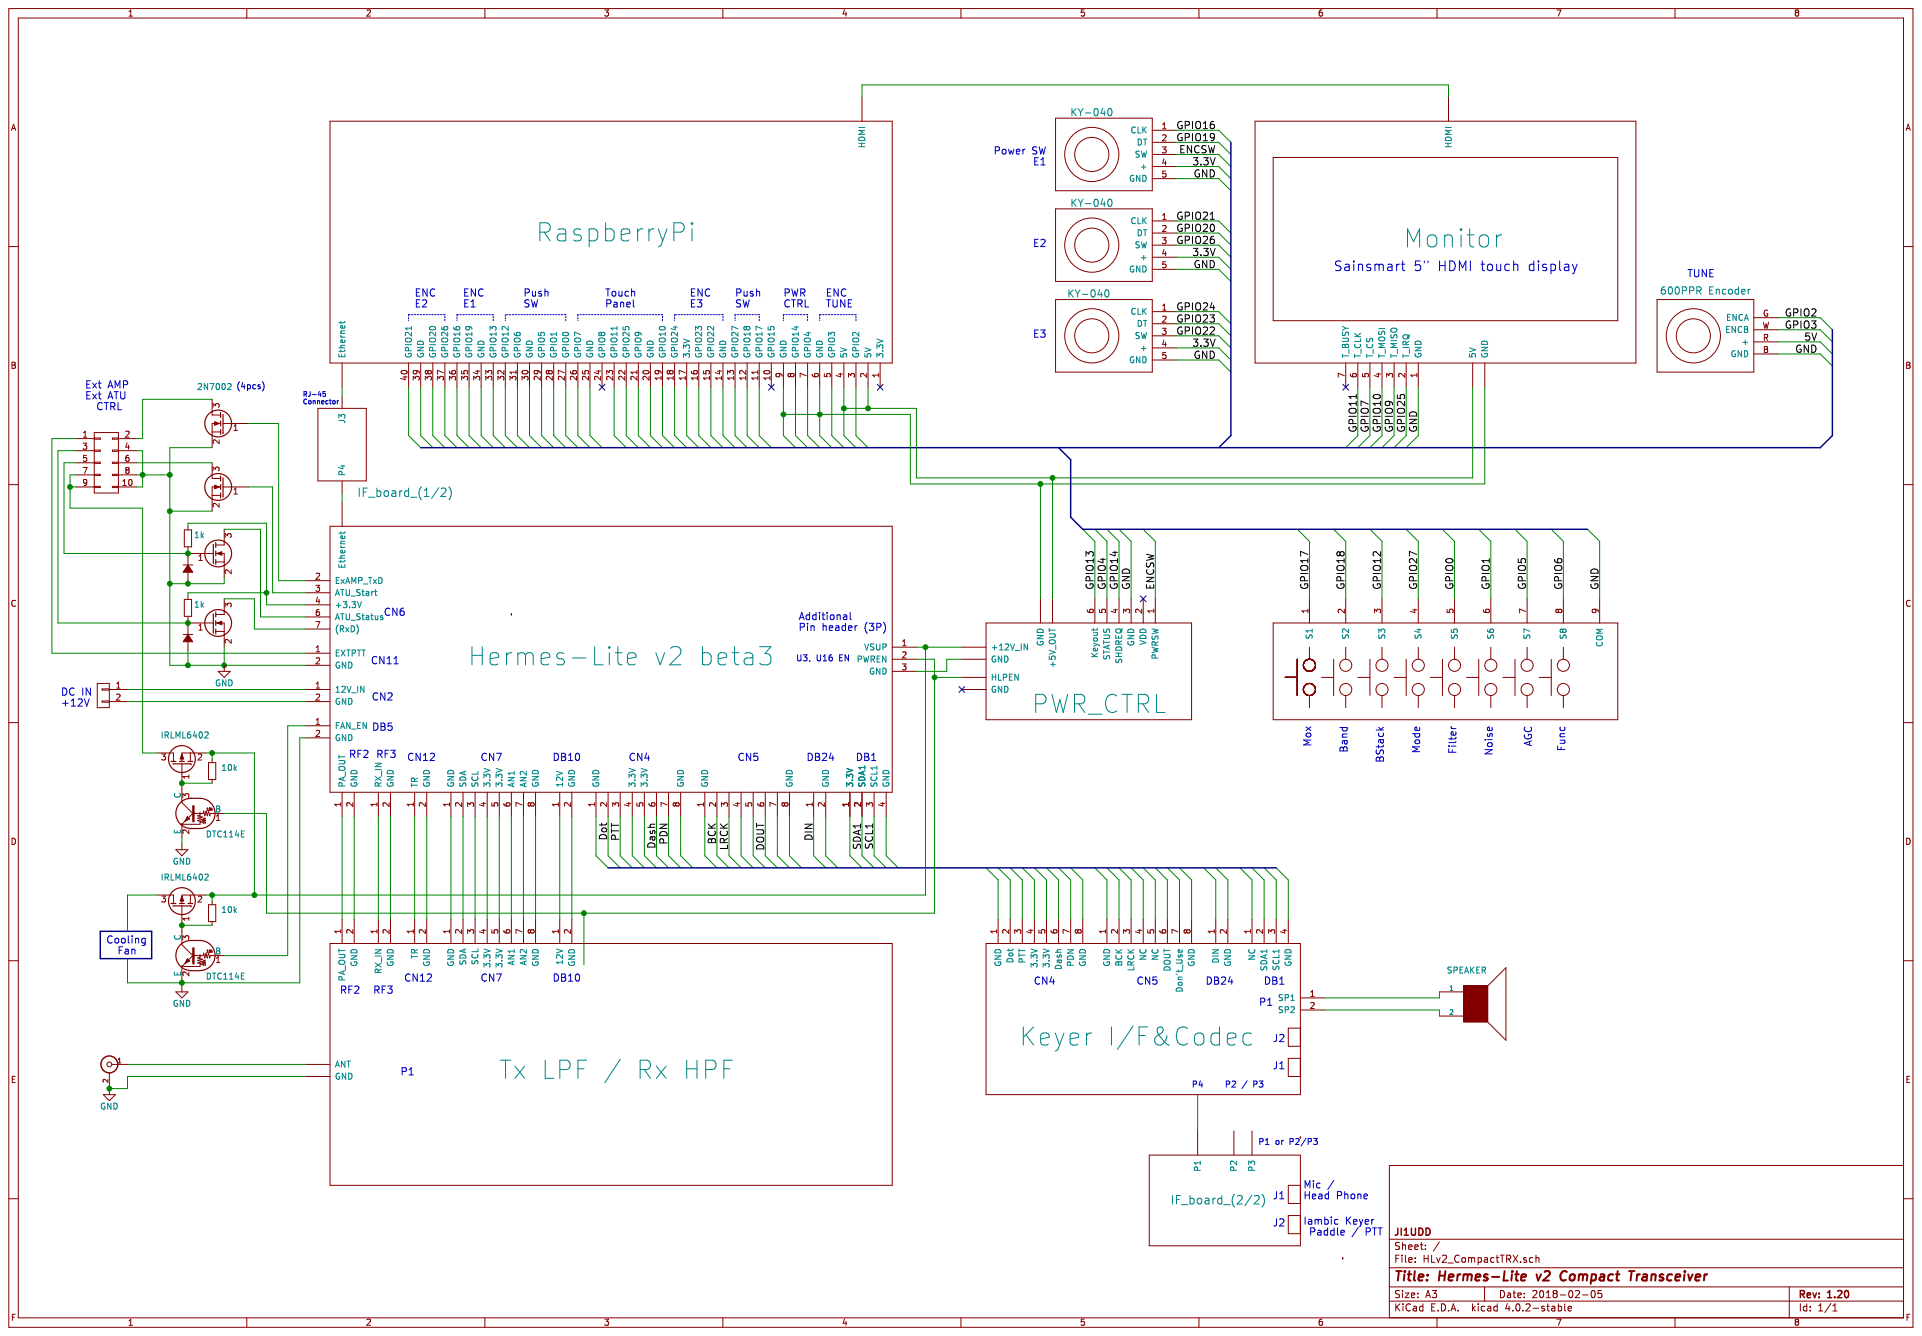
[picture p71: page 1]
