ji1udd/Hermes-Lite2/CTRX_HL2b5/docs/interface_HR50.pdf

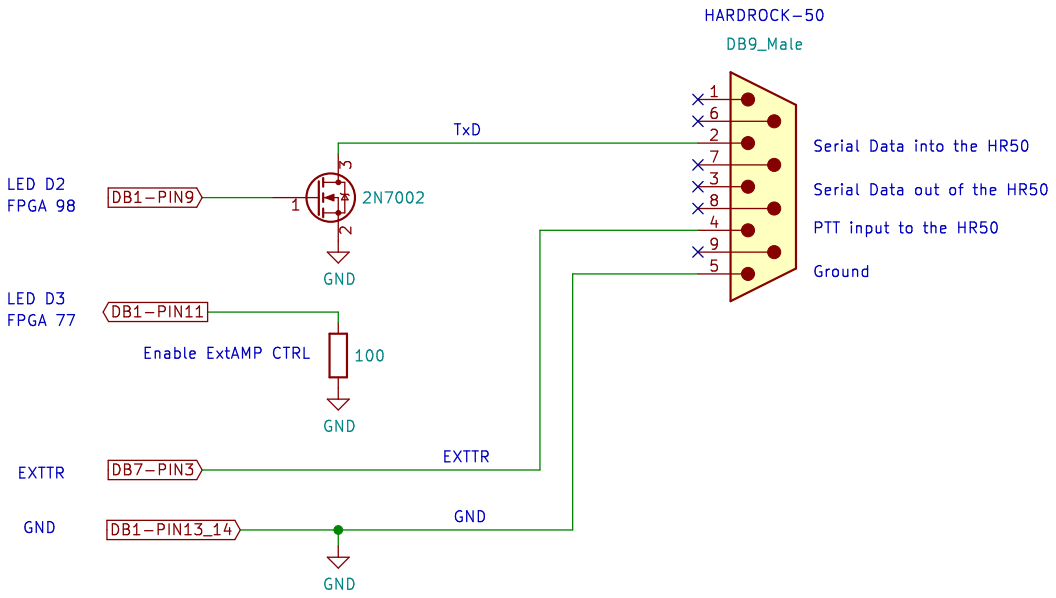
[picture p72: page 1]
