ji1udd/Hermes-Lite2/compact-trx/powercontrol/docs/ATU_CTRL_StateDiagram.pdf

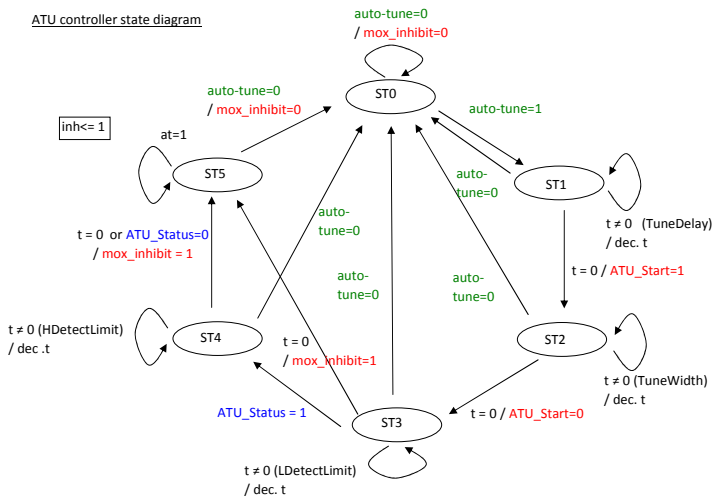
[picture p73: page 1]
auto-tune=0 / mox_inhibit=0; auto-tune=1; auto- tune=0; t ≠ 0 (TuneWidth) / dec. t; ATU_Status = 1; t = 0 / ATU_Start=0; auto-; tune=0; t ≠ 0 (TuneDelay); / dec. t; t ≠ 0 (LDetectLimit) / dec. t; t = 0 / mox_inhibit=1; inh<= 1; t ≠ 0 (HDetectLimit) / dec .t; t = 0 or ATU_Status=0 / mox_inhibit = 1; t = 0 / ATU_Start=1

ATU controller state diagram
