ji1udd/Hermes-Lite2/compact-trx/Keyer_AK4951/hermeslite.kicad_pcb

## KiCad design compact-trx/Keyer_AK4951/hermeslite.kicad_pcb (2017-08-17)

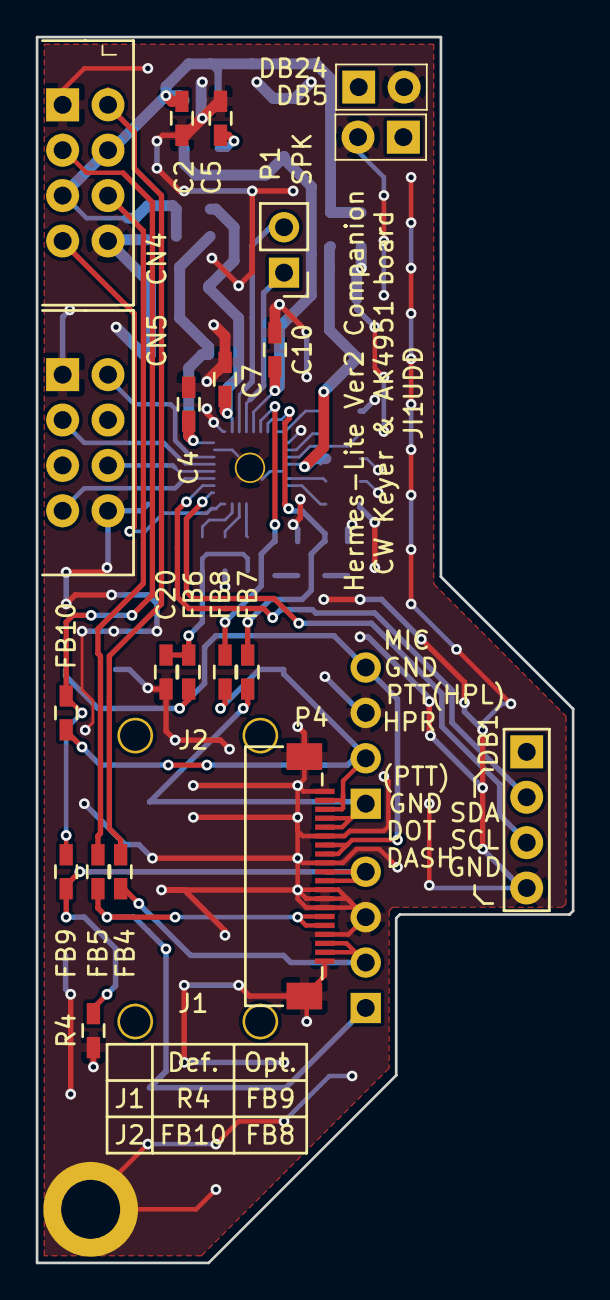
[picture p74: board compact-trx/Keyer_AK4951/hermeslite.kicad_pcb from above]

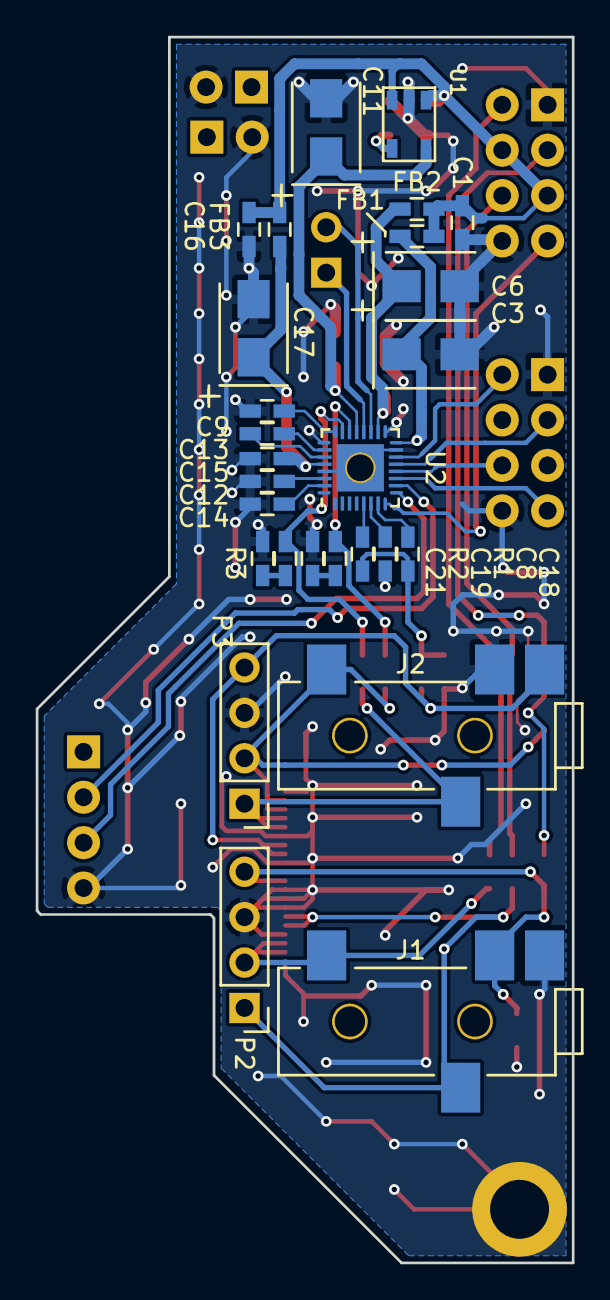
[picture p75: board compact-trx/Keyer_AK4951/hermeslite.kicad_pcb from below]

Board: 4 copper layers, 30.0 x 68.6 mm, 49 parts (27 on the bottom side), 38 nets.

Parts:
C1, C4, C5, C7, C10, C15, C16: 0.1u; C_0603_HandSoldering
C2, C8, C18: 1u; C_0603_HandSoldering
C3, C6, C11, C17: 10u; TantalC_SizeB_EIA-3528_Wave
C9, C12, C13, C14: 2.2u; C_0603_HandSoldering
C19, C21: 0.22u; C_0603_HandSoldering
C20: DNI; C_0603_HandSoldering
CN4, CN5: IO8; IO
DB1: RFD4d; 4x1
DB5, DB24: RFD2b; 2x1
FB1, FB2, FB3, FB4, FB5, FB6, FB7, FB8, FB9, FB10: FB; C_0603_HandSoldering
J1, J2: SJ-43514-SMT
MH2: DNI; m3
P1: CONN_01X02; Pin_Header_Straight_1x02_Pitch2.54mm
P2, P3: CONN_01X04; Pin_Header_Straight_1x04_Pitch2.54mm
P4: FFC 20pin; FFC_Kyocera_20pin
R1: 2.2k; C_0603_HandSoldering
R2, R3: 33; C_0603_HandSoldering
R4: 0; C_0603_HandSoldering
U1: TPS730; SOT23
U2: AK4951AEN; QFN-32-1EP_4x4mm_Pitch0.4mm_Handsoldering

Connections:
+3V3: C1.1, C2.1, C16.1, CN4.4, CN4.5, FB1.2, FB2.2, FB3.1, U1.1, U1.3
/AudioCodec/BCK: CN5.2, U2.14
/AudioCodec/DIN: CN5.7, U2.11
/AudioCodec/DOUT: CN5.6, U2.12
/AudioCodec/LRCK: CN5.3, U2.13
/AudioCodec/P2-1: FB5.2, J1.3, P2.1, P4.15, P4.16
/AudioCodec/P2-2: FB4.2, J1.2, P2.2, P4.18, P4.19
/AudioCodec/P2-4: FB9.1, J1.4, P2.4, P4.10, P4.11, R4.2
/AudioCodec/P3-1: FB7.2, J2.3, P3.1, P4.4, P4.5
/AudioCodec/P3-2: FB8.1, FB10.1, J2.2, P3.2, P4.2, P4.3
/AudioCodec/P3-4: FB6.2, J2.1, P3.4, P4.7, P4.8
/AudioCodec/PDN: CN4.7, U2.8
/AudioCodec/SCL: DB1.3, U2.9
/AudioCodec/SDA: DB1.2, U2.10
/AudioCodec/~DASH: CN4.6, FB5.1
/AudioCodec/~DOT: CN4.2, FB4.1
/AudioCodec/~PTT: CN4.3, FB9.2, FB10.2
GND: C1.2, C2.2, C3.2, C4.2, C5.2, C6.2, C7.2, C8.1, C9.2, C10.2, C11.2, C12.2, C14.2, C15.1, C16.2, C17.2, C20.2, CN4.1, CN4.8, CN5.1, CN5.8, DB1.4, DB5.2, DB24.2, J1.1, J2.4, MH2.1, P2.3, P3.3, P4.1, P4.6, P4.9, P4.12, P4.13, P4.14, P4.17, P4.20, P4.21, P4.22, R2.2, R3.2, R4.1, U1.2, U2.15, U2.17, U2.25, U2.29, U2.33
unnamed: C3.1, C4.1, FB1.1, U2.16
unnamed: C5.1, U1.4
unnamed: C6.1, C7.1, FB2.1, U2.18
unnamed: C8.2, U2.6
unnamed: C9.1, U2.24
unnamed: C10.1, C11.1, U1.5, U2.21
unnamed: C12.1, U2.30
unnamed: C13.1, U2.27
unnamed: C13.2, U2.26
unnamed: C14.1, U2.31
unnamed: C15.2, C17.1, FB3.2, U2.28
unnamed: C18.1, U2.7
unnamed: C18.2, C20.1, FB6.1, R1.1
unnamed: C19.1, FB8.2, U2.22
unnamed: C19.2, R2.1
unnamed: C21.1, FB7.1, U2.23
unnamed: C21.2, R3.1
unnamed: P1.1, U2.20
unnamed: P1.2, U2.19
unnamed: R1.2, U2.5
