ji1udd/Hermes-Lite2/compact-trx/TX_RX_Filter/hermeslite.kicad_pcb

## KiCad design compact-trx/TX_RX_Filter/hermeslite.kicad_pcb (2017-08-17)

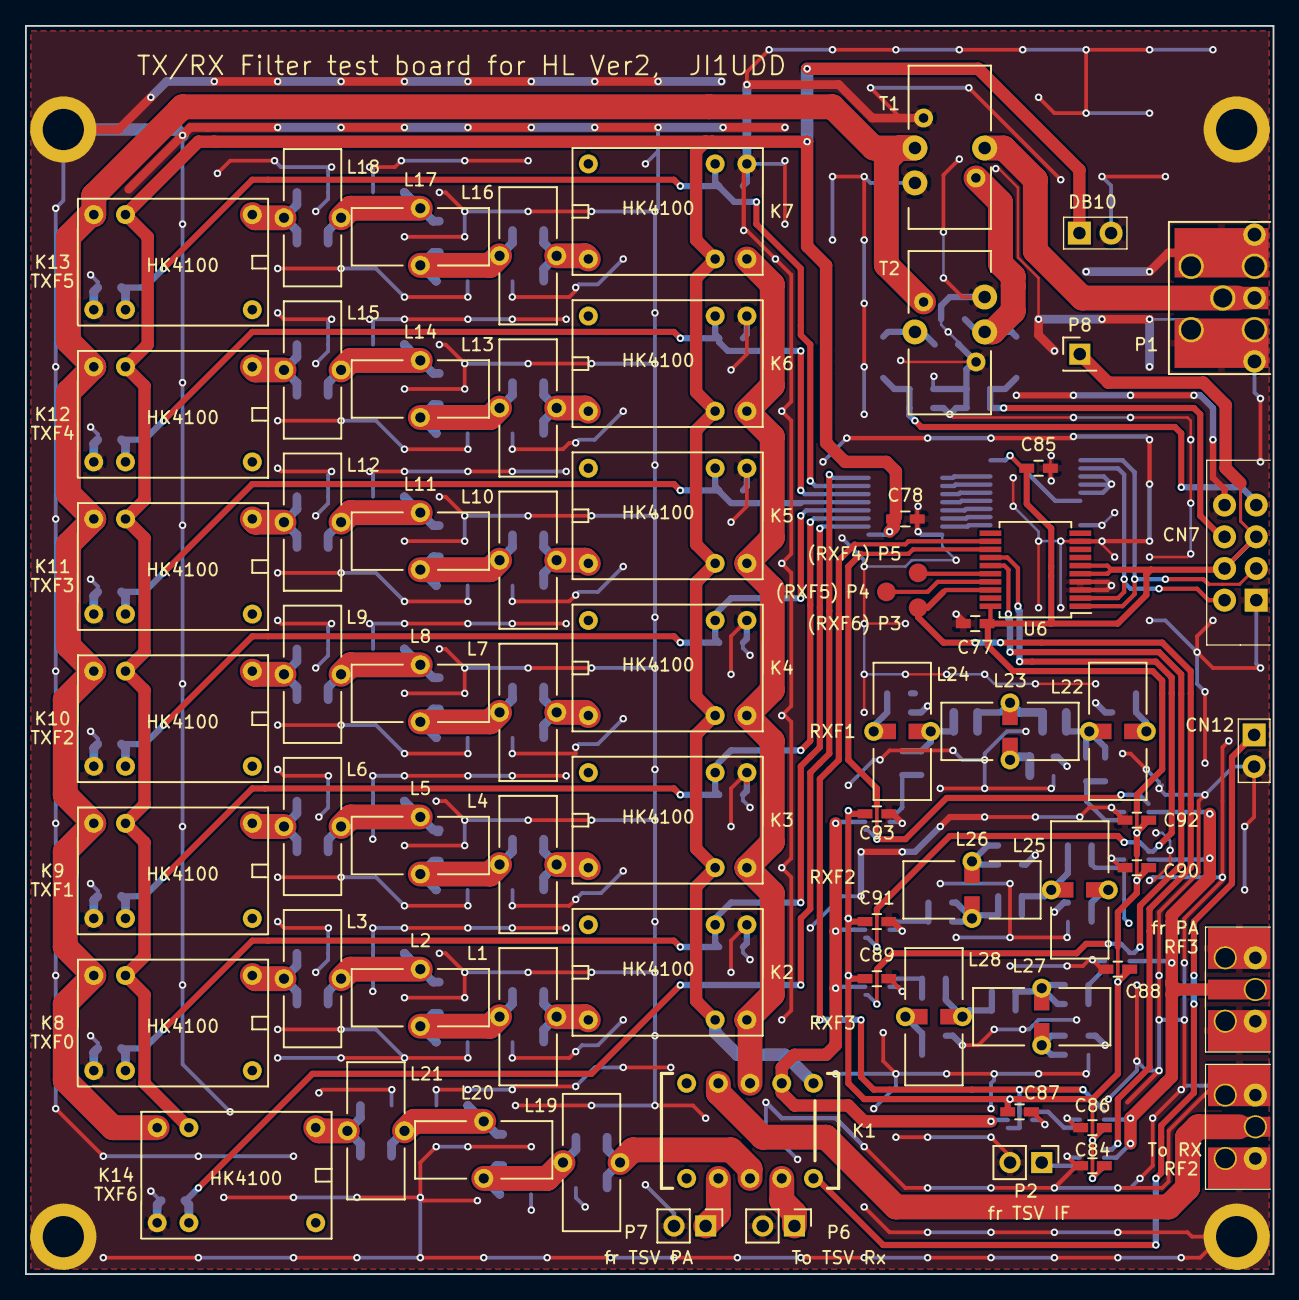
[picture p76: board compact-trx/TX_RX_Filter/hermeslite.kicad_pcb from above]

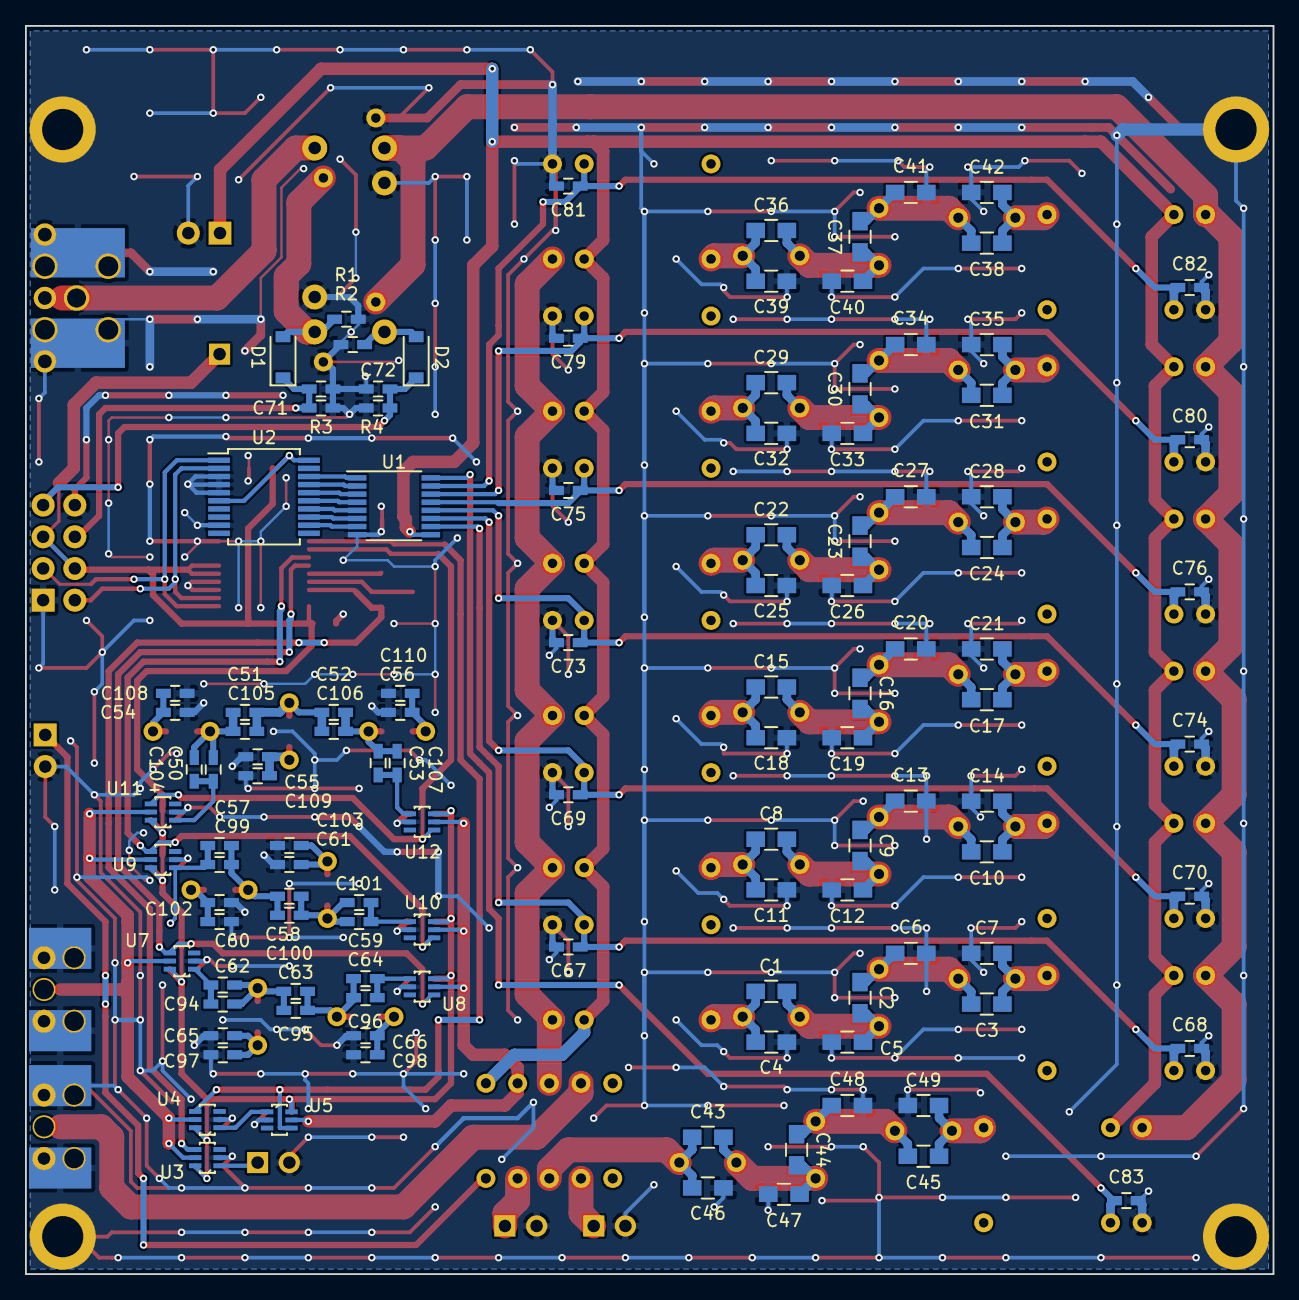
[picture p77: board compact-trx/TX_RX_Filter/hermeslite.kicad_pcb from below]

Board: 4 copper layers, 99.9 x 100.0 mm, 189 parts (115 on the bottom side), 89 nets.

Parts:
C1, C2, C3, C8, C9, C10, C17, C28, C29, C30, C31, C36, C37, C38, C43, C44, C45, C46, C47, C48, C49: DNI; C_0805_HandSoldering
C4, C7: 820p; C_0805_HandSoldering
C5, C6: 2200p; C_0805_HandSoldering
C11, C14: 470pF; C_0805_HandSoldering
C12, C13: 1200pF; C_0805_HandSoldering
C15: 100pf; C_0805_HandSoldering
C16: 300pf; C_0805_HandSoldering
C18: 360pF; C_0805_HandSoldering
C19: 680pF; C_0805_HandSoldering
C20: 270pF; C_0805_HandSoldering
C21: 240pF; C_0805_HandSoldering
C22: 43pF; C_0805_HandSoldering
C23, C27: 130pF; C_0805_HandSoldering
C24: 0R Res; C_0805_HandSoldering
C25: 180pF; C_0805_HandSoldering
C26: 300pF; C_0805_HandSoldering
C32, C35: 82pF; C_0805_HandSoldering
C33, C34: 220pF; C_0805_HandSoldering
C39, C42: 100p; C_0805_HandSoldering
C40, C41: 180p; C_0805_HandSoldering
C50, C51, C52, C53, C57, C58, C59, C62, C63, C64, C94, C95, C96, C99, C100, C101, C104, C105, C106, C107: DNI; C_0603_HandSoldering
C54, C55, C56, C60, C61, C65, C66, C97, C98, C102, C103, C108, C109, C110: 10p; C_0603_HandSoldering
C67, C68, C69, C70, C73, C74, C75, C76, C79, C80, C81, C82, C83: 10n; C_0603_HandSoldering
C71, C72, C77, C78, C84, C85, C86, C87, C88, C89, C90, C91, C92, C93: 100n; C_0603_HandSoldering
CN7: IO8; IO
CN12: RFD2b; 2x1
D1, D2: 1N5711; D_SOD-123
DB10: RFD2b; 2x1
K1: RELAY_EA2; Relay_EA2
K2, K3, K4, K5, K6, K7, K8, K9, K10, K11, K12, K13, K14: HK4100
L1, L3: 4.442u; T37_SL
L2: 5.608u; T37_SL
L4, L6: 2.434uH; T37_SL
L5: 3.012uH; T37_SL
L7: 1.156uH; T37_SL
L8: 676nH; T37_SL
L9: 576nH; T37_SL
L10: 642.5nH; T37_SL
L11: 455nH; T37_SL
L12, L19, L20, L21: DNI; T37_SL
L13, L15: 444nH; T37_SL
L14: 561nH; T37_SL
L16, L18: 330nH; T37_SL
L17: 270nH; T37_SL
L22, L23, L24, L25, L26, L27, L28: 330nH; T37_SL_SMD
MH1, MH2, MH3, MH4: DNI; m3
P1: SMA; rfconnectorB-1
P2, P6, P7: CONN_01X02; Pin_Header_Straight_1x02_Pitch2.54mm
P3, P4, P5: TST; Measurement_Point_Round-SMD-Pad_Small
P8: TST; Pin_Header_Straight_1x01_Pitch2.54mm
R1, R2: 50.1; C_0603_HandSoldering
R3, R4: 100k; C_0603_HandSoldering
RF2: SMA; SMAEDGE_TH
RF3: BNC; SMAEDGE_TH
T1, T2: PWR_TRANS_FS; FR-Power-Xfmr_FS
U1: TPL7407LPW; TSSOP-16_4.4x5mm_Pitch0.65mm
U2, U6: MCP23008-SS; SSOP-20_5.3x7.2mm_Pitch0.65mm
U3, U4, U5, U7, U8, U9, U10, U11, U12: PE4259

Connections:
+3V3: C77.1, C84.1, C85.1, C86.1, C87.1, C88.1, C89.1, C90.1, C91.1, C92.1, C93.1, CN7.4, CN7.5, P8.1, U2.6, U2.20, U3.6, U4.6, U5.6, U6.5, U6.6, U6.20, U7.6, U8.6, U9.6, U10.6, U11.6, U12.6
+12V: C78.1, DB10.1, K1.1, K2.5, K3.5, K4.5, K5.5, K6.5, K7.5, K8.5, K9.5, K10.5, K11.5, K12.5, K13.5, K14.5, U1.9
/TXF0: C67.1, C68.1, K2.2, K8.2, U1.10
/TXF1: C69.1, C70.1, K3.2, K9.2, U1.11
/TXF2: C73.1, C74.1, K4.2, K10.2, U1.12
/TXF3: C75.1, C76.1, K5.2, K11.2, U1.13
/TXF4: C79.1, C80.1, K6.2, K12.2, U1.14
/TXF5: C81.1, C82.1, K7.2, K13.2, U1.15
/TXF6: C83.1, K14.2, U1.16
/rx-filter/RX-FILTER-IN: K1.2, U5.5, U8.5, U10.5, U12.5
/tx-filter/AIN1: C71.2, CN7.6, D1.1, R3.1
/tx-filter/AIN2: C72.1, CN7.7, D2.1, R4.2
GND: C4.2, C5.2, C6.2, C7.2, C11.2, C12.2, C13.2, C14.2, C18.2, C19.2, C20.2, C21.2, C25.2, C26.2, C27.2, C28.2, C32.2, C33.2, C34.2, C35.2, C39.2, C40.2, C41.2, C42.2, C46.2, C47.2, C48.2, C49.2, C54.2, C55.2, C56.2, C60.2, C61.2, C65.2, C66.2, C67.2, C68.2, C69.2, C70.2, C71.1, C72.2, C73.2, C74.2, C75.2, C76.2, C77.2, C78.2, C79.2, C80.2, C81.2, C82.2, C83.2, C84.2, C85.2, C86.2, C87.2, C88.2, C89.2, C90.2, C91.2, C92.2, C93.2, C97.2, C98.2, C102.2, C103.2, C108.2, C109.2, C110.2, CN7.1, CN7.8, CN12.2, DB10.2, K2.1, K3.1, K4.1, K5.1, K6.1, K7.1, K8.1, K9.1, K10.1, K11.1, K12.1, K13.1, K14.1, MH1.1, MH2.1, MH3.1, MH4.1, P1.2, P2.2, P6.2, P7.2, R1.2, R2.1, R3.2, R4.1, RF2.2, RF3.2, T1.3, T1.5, T2.3, T2.5, U1.8, U2.3, U2.4, U2.5, U2.9, U3.2, U4.2, U5.2, U6.3, U6.4, U6.9, U7.2, U8.2, U9.2, U10.2, U11.2, U12.2
unnamed: C1.1, C2.2, C5.1, L1.2, L2.1
unnamed: C1.2, C4.1, K2.4, L1.1
unnamed: C2.1, C3.2, C6.1, L2.2, L3.1
unnamed: C3.1, C7.1, K8.4, L3.2
unnamed: C10.1, C14.1, K9.4, L6.2
unnamed: C9.1, C10.2, C13.1, L5.2, L6.1
unnamed: C8.2, C11.1, K3.4, L4.1
unnamed: C8.1, C9.2, C12.1, L4.2, L5.1
unnamed: C15.1, C16.2, C19.1, L7.2, L8.1
unnamed: C15.2, C18.1, K4.4, L7.1
unnamed: C16.1, C17.2, C20.1, L8.2, L9.1
unnamed: C17.1, C21.1, K10.4, L9.2
unnamed: C22.1, C23.2, C26.1, L10.2, L11.1
unnamed: C22.2, C25.1, K5.4, L10.1
unnamed: C23.1, C24.2, C27.1, L11.2, L12.1
unnamed: C24.1, C28.1, K11.4, L12.2
unnamed: C29.1, C30.2, C33.1, L13.2, L14.1
unnamed: C29.2, C32.1, K6.4, L13.1
unnamed: C30.1, C31.2, C34.1, L14.2, L15.1
unnamed: C31.1, C35.1, K12.4, L15.2
unnamed: C36.1, C37.2, C40.1, L16.2, L17.1
unnamed: C36.2, C39.1, K7.4, L16.1
unnamed: C37.1, C38.2, C41.1, L17.2, L18.1
unnamed: C38.1, C42.1, K13.4, L18.2
unnamed: C43.1, C44.2, C47.1, L19.2, L20.1
unnamed: C44.1, C45.2, C48.1, L20.2, L21.1
unnamed: C45.1, C49.1, K14.4, L21.2
unnamed: C57.2, C99.2, U9.1
unnamed: C62.1, C63.2, C94.1, C95.2, L27.1
unnamed: C62.2, C94.2, U7.1
unnamed: C63.1, C64.2, C95.1, C96.2, L28.1
unnamed: C64.1, C96.1, U8.1
unnamed: C65.1, C97.1, L27.2
unnamed: C66.1, C98.1, L28.2
unnamed: C58.1, C59.2, C100.1, C101.2, L26.1
unnamed: C57.1, C58.2, C99.1, C100.2, L25.1
unnamed: C59.1, C101.1, U10.1
unnamed: C60.1, C102.1, L25.2
unnamed: C61.1, C103.1, L26.2
unnamed: C50.1, C51.2, C104.1, C105.2, L22.1
unnamed: C50.2, C104.2, U11.1
unnamed: C51.1, C52.2, C105.1, C106.2, L23.1
unnamed: C52.1, C53.2, C106.1, C107.2, L24.1
unnamed: C53.1, C107.1, U12.1
unnamed: C54.1, C108.1, L22.2
unnamed: C55.1, C109.1, L23.2
unnamed: C56.1, C110.1, L24.2
unnamed: CN12.1, K1.10
unnamed: D1.2, R1.1, T1.4, T2.1
unnamed: D2.2, R2.2, T2.2
unnamed: K1.4, RF2.1
unnamed: K1.7, P7.1
unnamed: K1.9, P6.1
unnamed: K8.6, K9.6, K10.6, K11.6, K12.6, K13.6, K14.6, T1.1, T2.4
unnamed: P1.1, T1.2
unnamed: P2.1, U3.1
unnamed: P4.1, U6.17
unnamed: P5.1, U6.16
unnamed: RF3.1, U3.5, U4.5, U7.5, U9.5, U11.5
unnamed: U1.1, U2.18
unnamed: U1.2, U2.17
unnamed: U1.3, U2.16
unnamed: U1.4, U2.15
unnamed: U1.5, U2.14
unnamed: U1.6, U2.13
unnamed: U1.7, U2.12
unnamed: U4.1, U5.1
RXF0: U4.4, U5.4, U6.12
RXF1: U6.13, U11.4, U12.4
RXF2: U6.14, U9.4, U10.4
RXF3: U6.15, U7.4, U8.4
RXF6: P3.1, U3.4, U6.18
SCL: CN7.3, U2.1, U6.1
SDA: CN7.2, U2.2, U6.2
TSV-FILTER: C43.2, C46.1, K1.8, L19.1
TX-FILTER-IN: K1.3, K2.6, K3.6, K4.6, K5.6, K6.6, K7.6
