ji1udd/Hermes-Lite2/hardware/hl/hermeslite.kicad_pcb

## KiCad design hardware/hl/hermeslite.kicad_pcb (2017-08-14)

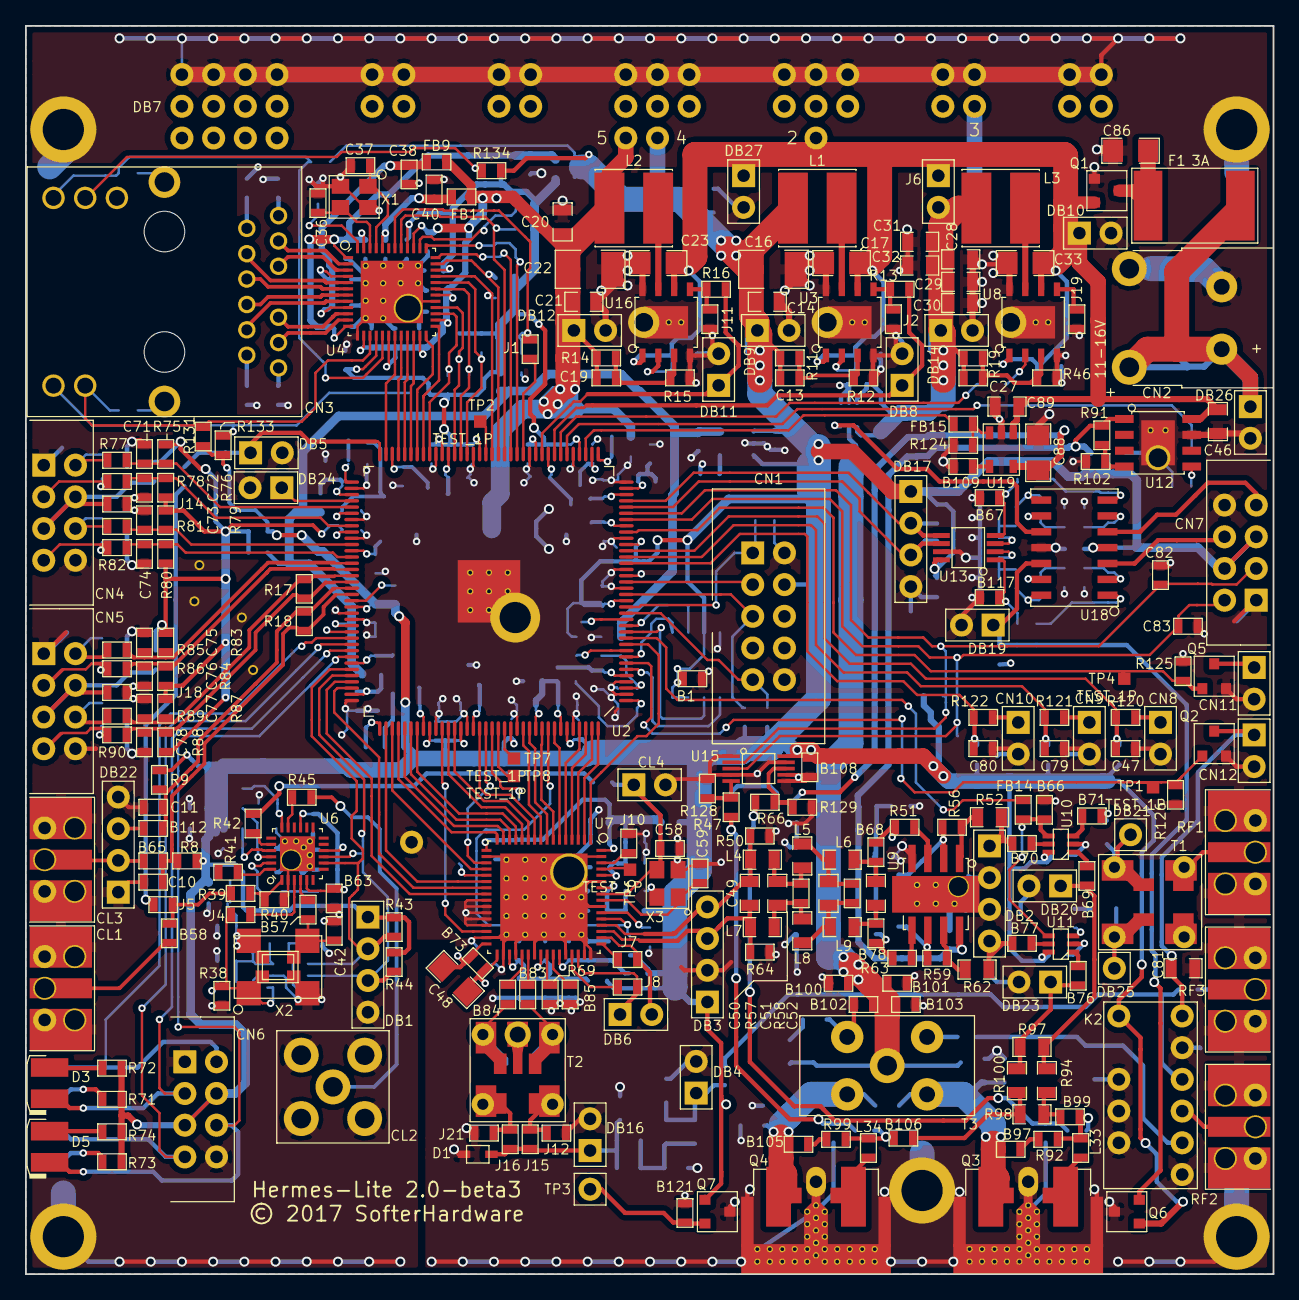
[picture p78: board hardware/hl/hermeslite.kicad_pcb from above]

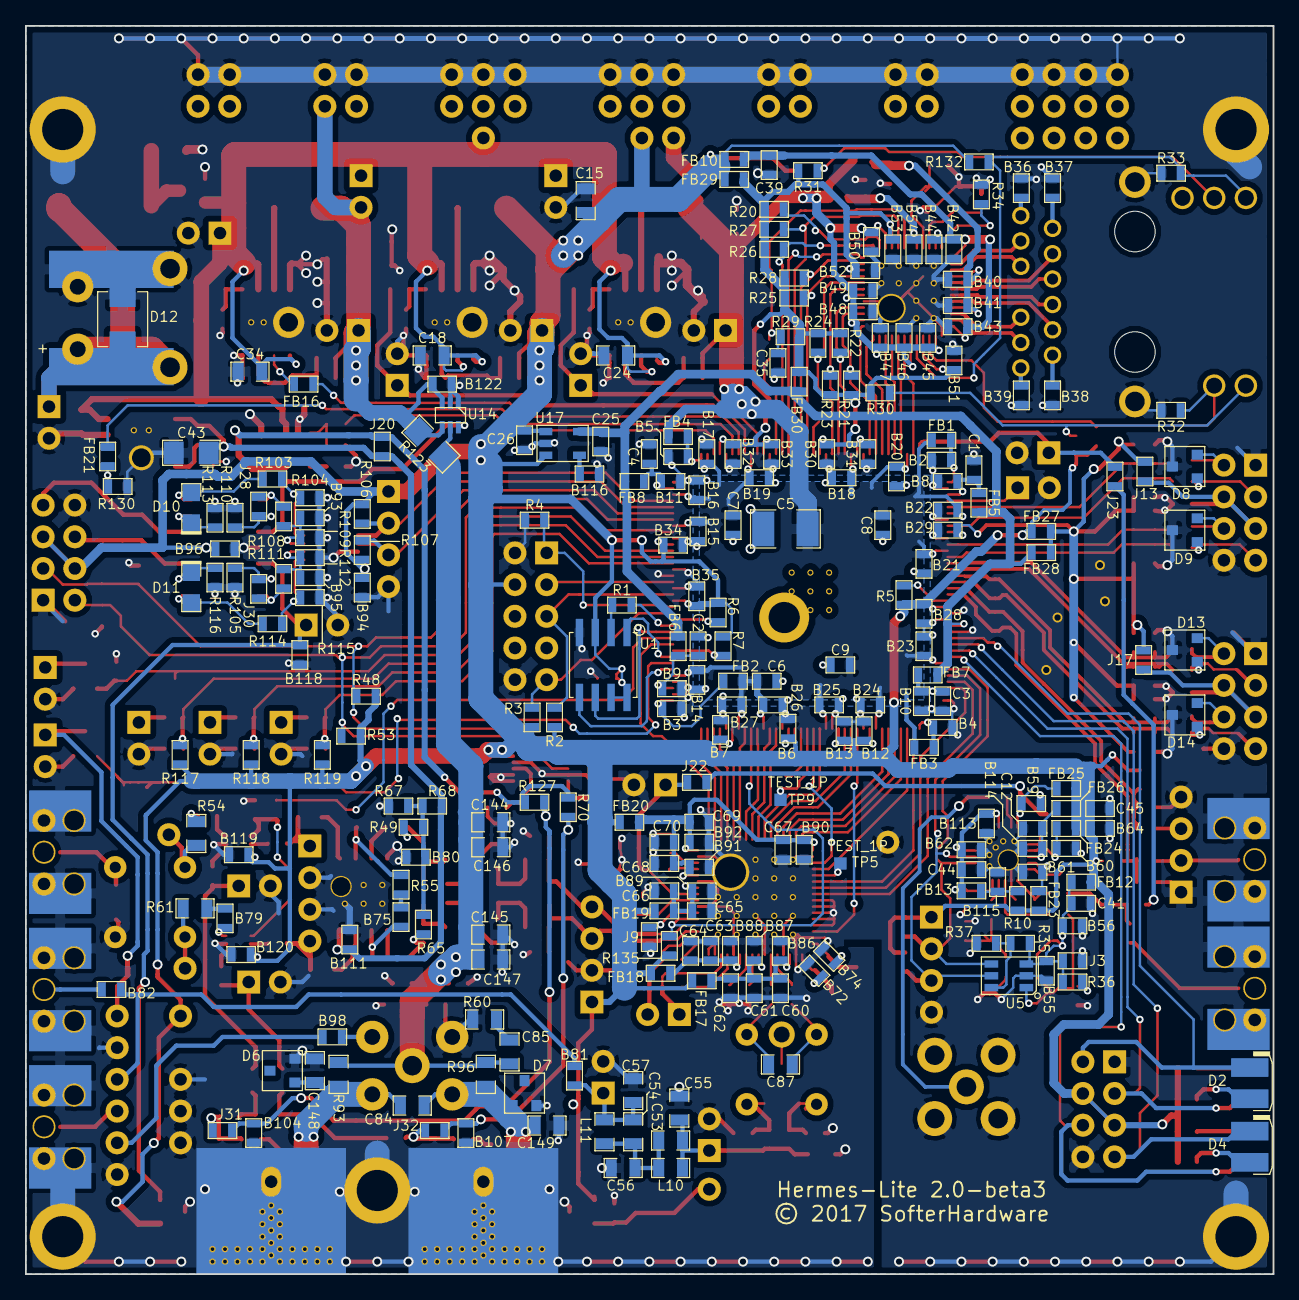
[picture p79: board hardware/hl/hermeslite.kicad_pcb from below]

Board: 4 copper layers, 99.9 x 100.0 mm, 528 parts (253 on the bottom side), 288 nets.

Parts:
B1, B2, B3, B4, B5, B6, B7, B8, B9, B10, B11, B12, B13, B14, B15, B16, B17, B18, B19, B20, B21, B22, B23, B24, B25, B26, B27, B28, B29, B30, B31, B32, B33, B34, B35, B36, B37, B38, B39, B40, B41, B42, B43, B44, B45, B46, B47, B48, B49, B50, B51, B52, B53, B54, B55, B56, B57, B58, B59, B60, B61, B62, B63, B64, B65, B66, B67, B68, B69, B70, B71, B72, B73, B74, B75, B76, B77, B78, B79, B80, B81, B82, B83, B84, B85, B86, B87, B88, B89, B90, B91, B92, B93, B94, B95, B96, B97, B98, B99, B100, B101, B102, B103, B104, B105, B106, B107, B108, B109, B111, B112, B113, B114, B115, B116, B117, B118, B119, B120, B121, B122: 0.1uF; SMD-0603
C1, C2, C3, C4, C6, C7, C8, C9, C12, C25, C35, C38, C39, C40, C41, C44, C45, C62, C64, C66, C70: 10uF; SMD-0603
C5, C16, C22: 100uF; SMD-1210
C10, C11, C42: DNI; SMD-0603
C13, C19, C27: 4.7nF; SMD-0603
C14, C15, C20, C21, C28, C29, C30, C31, C32: 22uF; SMD-0805
C17, C23, C33, C43, C48, C86, C88: 10uF; SMD-1206
C18, C24, C34: 4.7uF; SMD-0805
C26, C47, C60, C61, C63, C65, C67, C68, C69, C71, C72, C73, C74, C75, C76, C77, C78, C79, C80, C82, C83: 1uF; SMD-0603
C36, C37, C58, C59: 15pF; SMD-0603
C46, C89, C144, C145, C146, C147: 1uF; SMD-0805
C49: 75pF; SMD-0805
C50: 150pF; SMD-0805
C51: 160pF; SMD-0805
C52, C57, C81: 100pF; SMD-0805
C53: 10pF; SMD-0805
C54, C55, C85, C148, C149: DNI; SMD-0805
C56: 180pF; SMD-0805
C84: 270pF; SMD-0805
C87: 8.2pF; SMD-0805
CL1, CL3: SMA; SMAEDGE_TH
CL2: SMA; SMAVERT
CL4: RFD2b; 2x1
CN1: USBBlaster2; USBBLASTER
CN2: PS; POWERPP
CN3: MagJack; MAGJACK
CN4, CN5, CN6, CN7: IO8; IO
CN8, CN9, CN10, CN11, CN12: RFD2b; 2x1
D1: TVS; SOD323
D2, D3, D4, D5: Led_Small; LED
D6, D7: DNI; SOT23_3
D8, D9, D13, D14: SM05; SOT23_3
D10, D11: 1N5711; 1N5711WS
D12: SMBJ18CA; smbj18ca
DB1, DB2, DB3: RFD4d; 4x1
DB4, DB5, DB16: RFD2a; 2x1
DB6, DB8, DB9, DB10, DB11, DB12, DB14, DB19, DB20, DB23, DB24, DB26, DB27: RFD2b; 2x1
DB7: IO6; PROTOSTRIP
DB17: RFD4b; 4x1
DB21, DB25: DNI; 1x1
DB22: RFD4f; 4x1
F1: 3A@20V; FUSE
FB1, FB2, FB3, FB4, FB5, FB6, FB7, FB8, FB9, FB10, FB11, FB12, FB13, FB14, FB15, FB16, FB17, FB18, FB19, FB20, FB21, FB23, FB24, FB25, FB26, FB27, FB28, FB29, FB30: FB; SMD-0603
GT1, GT2, GT3, GT4: DNI; GNDTAP
J1, J2, J9, J10, J11, J14, J15, J18, J19, J21, J22, J28, J30, J31, J32: JNC; SMD-0603
J3, J4, J5, J7, J8, J12, J13, J16, J17, J20, J23: JNO; SMD-0603
J6: RFD2b; 2x1
K2: NA3WK-K; DPDT_GND
L1, L3: 3.3uH; GENERICPSL
L2: 2.2uH; GENERICPSL
L4, L7: 240nH; SMD-0805
L5, L6, L8, L9: 270nH; SMD-0805
L10, L11: 330nH; SMD-0805
L33, L34: 0nH; SMD-0603
MH1, MH2, MH3, MH4, MH5: DNI; m3
MH6: DNI; m1d1
Q1: DMP3099L; SOT23_3
Q2, Q5: NUD3124; SOT23_3
Q3, Q4: LDMOS; COMBORFGND
Q6, Q7: MCP9700; SOT23_3
R1, R13, R16, R41, R42, R45, R50, R64: 33; SMD-0603
R2, R3, R4, R5, R6, R7, R14, R21, R22, R23, R24, R25, R27, R28, R29, R37, R131, R132: 10K; SMD-0603
R8, R9, R17, R18, R36, R38, R128, R129: DNI; SMD-0603
R10: 2.2; SMD-0603
R11: 35.7K; SMD-0603
R12, R91: 11.5K; SMD-0603
R15: 20K; SMD-0603
R19: 16.2K; SMD-0603
R20, R26, R49, R65, R75, R76, R79, R80, R83, R84, R87, R88: 2.2K; SMD-0603
R30, R31, R92, R99: 270; SMD-0603
R32, R33, R57, R58, R67, R68, R71, R72, R73, R74, R103, R108, R111, R114: 1K; SMD-0603
R34: 12.1K; SMD-0603
R35, R117, R118, R119: 3.3K; SMD-0603
R39: 120; SMD-0603
R40, R55: 75; SMD-0603
R43, R44, R48, R53, R106, R107, R124, R125, R126, R130, R135: 4.7K; SMD-0603
R46, R104, R109, R112, R115: 1.8K; SMD-0603
R47, R66: 9.1K; SMD-0603
R51, R63: 22; SMD-0603
R52, R54, R61, R62, R94, R100: 12; SMD-0805
R56, R59, R133, R134: 330; SMD-0603
R60, R93, R96, R97, R98: DNI; SMD-0805
R69, R102: 1.6K; SMD-0603
R70, R127: 27K; SMD-0603
R77, R78, R81, R82, R85, R86, R89, R90, R120, R121, R122: 100; SMD-0603
R105, R110, R113, R116: 220K; SMD-0603
R123: 0.04; SMD-1206
RF1, RF3: BNC; SMAEDGE_TH
RF2: SMA; SMAEDGE_TH
T1: 1:1 Z; TRANSFSMT4
T2: 8:1 Z; TRANSFSMT
T3: 4:1 Z; BN202V
TP1, TP2, TP4, TP5, TP6, TP7, TP8, TP9: TEST_1P; TP
TP3: TEST_1P; 1x1
U1: EEPROM; SOIC-8
U2: FPGA; CYCLONEIV
U3, U8, U16: ST1S10
U4: KSZ9031RN; KSZ9031
U5: MCP4716
U6: 5P49V5923; IDTVERSA
U7: AD9866BCPZ; AD9866
U9: OPA2677
U10, U11: PE4259
U12: AP2204; ap2204
U13: MAX11613
U14: INA199A1DC; PE4259
U15: MCP4662; SOIC-10
U17: TPS730; SOT23
U18: LMV324
U19: LP2985; SOT23
X1: 25MHz; XTAL
X2: 38.4MHz; MULTIOSC
X3: 38.4MHz; XTAL

Connections:
+1V2: B14.1, B15.1, B16.1, B17.1, B18.1, B19.1, B20.1, B21.1, B22.1, B23.1, B24.1, B25.1, B26.1, B27.1, B45.1, B46.1, B47.1, B48.1, B49.1, B50.1, C5.2, C6.2, C7.2, C8.2, C9.2, C19.1, C20.1, C21.1, C22.1, DB7.5, DB12.1, FB1.1, FB2.1, FB3.1, FB4.1, FB9.1, FB11.1, L2.2, R14.1, U2.5, U2.29, U2.34, U2.38, U2.45, U2.61, U2.70, U2.78, U2.84, U2.102, U2.116, U2.124, U2.134, U2.138, U4.14, U4.18, U4.23, U4.26, U4.30, U4.39
+2V5: C25.1, FB5.1, FB6.1, FB7.1, FB8.1, FB28.1, FB30.1, U2.96, U17.5
+3V3: B1.1, B6.1, B7.1, B12.1, B13.1, B28.1, B34.1, B35.1, B64.1, B94.1, B96.1, B108.1, B119.1, B120.1, C13.1, C14.1, C15.1, C16.1, C26.1, C45.1, CN1.4, CN6.4, CN6.5, CN7.4, CN7.5, DB1.1, DB3.1, DB7.4, DB9.1, DB17.1, FB10.2, FB12.2, FB17.2, FB18.1, FB19.1, FB20.2, FB23.2, FB24.2, FB25.2, FB26.2, FB27.1, FB29.1, K2.1, L1.2, Q6.1, Q7.1, R2.2, R3.2, R5.2, R6.2, R7.2, R8.2, R9.2, R10.1, R11.1, R43.2, R44.2, R48.2, R53.2, R71.2, R72.2, R73.2, R74.2, R106.2, R107.2, R117.2, R118.2, R119.2, R131.1, R132.1, R133.2, R134.2, R135.2, U1.3, U1.7, U1.8, U2.17, U2.26, U2.93, U2.117, U2.122, U2.130, U2.139, U10.6, U11.6, U13.8, U15.10, U17.1, U17.3, U18.4
+VBIAS: C88.1, J20.1, R70.2, R127.2, U19.5
+VOP: B111.2, C43.1, J20.2, R68.2, R91.1, U9.8, U12.1
+VPA: B122.1, C27.1, C28.1, C29.1, C30.1, C31.1, C32.1, DB7.3, DB14.1, J6.2, L3.2, R19.1, R123.1, U14.3, U14.4
/Clock/SCL1: DB1.3, R44.1, U2.104, U5.5, U6.9
/Clock/SDA1: DB1.2, R43.1, U2.103, U5.4, U6.8
/Ethernet/RXD0: R24.2, U2.58, U4.32
/Ethernet/RXD1: R23.2, U2.59, U4.31
/Ethernet/RXD2: R22.2, U2.60, U4.28
/Ethernet/RXD3: R21.2, U2.64, U4.27
/Ethernet/TXD0: U2.71, U4.19
/Ethernet/TXD1: U2.69, U4.20
/Ethernet/TXD2: U2.68, U4.21
/Ethernet/TXD3: U2.67, U4.22
/Input Output/AIN1: CN7.6, U18.3
/Input Output/AIN2: CN7.7, U18.5
/PA/TR: C81.1, CN12.1, K2.12, Q2.3
/PA/bias0: B104.2, J31.2, R66.2, R127.1
/PA/bias1: B107.2, J32.2, R47.2, R70.1
/RF Frontend/Vop/2: B80.2, R49.1, R65.2, R67.2, R68.1
GND: B1.2, B2.2, B3.2, B4.2, B5.2, B6.2, B7.2, B8.2, B9.2, B10.2, B11.2, B12.2, B13.2, B14.2, B15.2, B16.2, B17.2, B18.2, B19.2, B20.2, B21.2, B22.2, B23.2, B24.2, B25.2, B26.2, B27.2, B28.2, B29.2, B30.2, B31.2, B32.2, B33.2, B34.2, B35.2, B36.2, B37.2, B38.2, B39.2, B40.2, B41.2, B42.2, B43.2, B44.2, B45.2, B46.2, B47.2, B48.2, B49.2, B50.2, B51.2, B52.2, B53.2, B54.2, B55.2, B56.2, B59.2, B60.2, B61.2, B62.2, B63.2, B64.2, B66.1, B67.2, B72.2, B74.2, B80.1, B85.2, B86.2, B87.2, B88.2, B89.2, B90.2, B91.2, B92.2, B93.2, B94.2, B95.2, B96.2, B100.1, B101.1, B102.1, B103.1, B104.1, B107.1, B108.2, B109.2, B111.1, B113.2, B114.2, B115.2, B116.2, B117.2, B118.2, B119.2, B120.2, B121.2, B122.2, C1.2, C2.2, C3.2, C4.2, C5.1, C6.1, C7.1, C8.1, C9.1, C10.2, C11.2, C12.2, C14.2, C15.2, C16.2, C17.2, C18.2, C20.2, C21.2, C22.2, C23.2, C24.2, C25.2, C26.2, C28.2, C29.2, C30.2, C31.2, C32.2, C33.2, C34.2, C35.2, C36.2, C37.2, C38.2, C39.2, C40.2, C41.2, C42.1, C43.2, C44.2, C45.2, C46.2, C47.2, C55.2, C56.2, C57.2, C58.2, C59.2, C60.2, C61.2, C62.2, C63.2, C64.2, C65.2, C66.2, C67.2, C68.2, C69.2, C70.2, C71.2, C72.2, C73.2, C74.2, C75.2, C76.2, C77.2, C78.2, C79.2, C80.2, C81.2, C82.2, C83.2, C86.2, C88.2, C89.2, C144.2, C145.2, C146.2, C147.2, C148.2, C149.2, CL1.2, CL2.2, CL3.2, CL4.2, CN1.2, CN1.10, CN2.2, CN3.18, CN4.1, CN4.8, CN5.1, CN5.8, CN6.1, CN6.8, CN7.1, CN7.8, CN8.2, CN9.2, CN10.2, CN11.2, CN12.2, D1.2, D6.2, D7.2, D8.3, D9.3, D12.2, D13.3, D14.3, DB1.4, DB2.2, DB2.3, DB3.2, DB4.2, DB5.2, DB7.1, DB8.2, DB9.2, DB10.2, DB11.2, DB12.2, DB14.2, DB16.2, DB17.4, DB19.2, DB20.2, DB22.1, DB22.4, DB23.2, DB24.2, DB26.2, DB27.2, GT1.1, GT2.1, GT3.1, GT4.1, J2.1, J3.2, J9.1, J10.1, J11.1, J12.2, J14.1, J18.1, J19.1, J21.1, K2.3, K2.4, K2.5, K2.7, K2.11, MH1.1, MH2.1, MH3.1, MH4.1, MH5.1, MH6.1, Q1.1, Q2.2, Q3.2, Q4.2, Q5.2, Q6.3, Q7.3, R4.2, R12.2, R15.2, R32.2, R33.2, R34.2, R37.2, R38.2, R40.2, R46.2, R50.2, R60.1, R64.1, R67.1, R69.1, R102.1, R104.1, R105.2, R109.1, R110.2, R112.1, R113.2, R115.1, R116.2, R124.1, R125.1, R126.1, R128.1, R129.1, R130.1, RF1.2, RF2.2, RF3.2, T1.3, T3.4, U1.4, U2.2, U2.4, U2.19, U2.21, U2.22, U2.27, U2.36, U2.41, U2.48, U2.57, U2.63, U2.74, U2.79, U2.82, U2.94, U2.95, U2.97, U2.108, U2.118, U2.123, U2.131, U2.140, U2.145, U3.4, U3.8, U3.9, U4.13, U4.29, U4.49, U5.2, U6.2, U6.25, U7.18, U7.25, U7.26, U7.27, U7.28, U7.29, U7.31, U7.34, U7.36, U7.39, U7.44, U7.47, U7.48, U7.55, U7.59, U7.63, U7.65, U8.4, U8.8, U8.9, U9.4, U10.2, U11.2, U12.7, U13.7, U14.1, U14.2, U15.1, U15.4, U15.6, U15.7, U15.9, U16.4, U16.8, U16.9, U17.2, U18.11, U19.2, X1.3, X2.2, X3.3
unnamed: B2.1, FB1.2, U2.73
unnamed: B3.1, FB2.2, U2.1
unnamed: B4.1, FB3.2, U2.109
unnamed: B5.1, FB4.2, U2.37
unnamed: B8.1, C1.1, FB5.2, U2.75
unnamed: B9.1, C2.1, FB6.2, U2.3
unnamed: B10.1, C3.1, FB7.2, U2.107
unnamed: B11.1, C4.1, FB8.2, U2.35
unnamed: B36.1, CN3.12
unnamed: B37.1, CN3.6
unnamed: B38.1, CN3.1
unnamed: B39.1, CN3.7
unnamed: B40.1, B41.1, C38.1, FB9.2, U4.4, U4.9
unnamed: B42.1, B43.1, B44.1, C39.1, FB10.1, U4.1, U4.12, U4.47
unnamed: B54.1, C40.1, FB11.2, U4.44
unnamed: B55.1, B56.1, C41.1, FB12.1, J3.1, R35.1, R36.1, U5.3, X2.4
unnamed: B57.1, C42.2, X2.3
unnamed: B57.2, U6.4
unnamed: B58.1, J5.1, R39.2
unnamed: B58.2, CL1.1
unnamed: B59.1, FB25.1, U6.18
unnamed: B60.1, FB24.1, U6.21
unnamed: B61.1, FB23.1, U6.23
unnamed: B65.1, CL3.1, DB22.2
unnamed: B65.2, C10.1, R8.1, R18.1, U2.91
unnamed: B66.2, FB14.1, U10.4, U11.4
unnamed: B67.1, R103.1, R104.2, U13.4
unnamed: B68.1, R49.2, R51.2
unnamed: B68.2, C52.1, L6.2
unnamed: B69.1, U10.1
unnamed: B70.1, U10.5
unnamed: B70.2, DB2.1, R52.1
unnamed: B71.1, U10.3
unnamed: B71.2, R54.2
unnamed: B72.1, B73.1, C48.1, U7.33
unnamed: B73.2, B74.1, C48.2, U7.32
unnamed: B75.1, R59.2, U9.6
unnamed: B75.2, R55.1
unnamed: B76.1, U11.1
unnamed: B77.1, U11.5
unnamed: B77.2, DB2.4, R62.1
unnamed: B78.1, R63.2, R65.1
unnamed: B78.2, C52.2, L9.1
unnamed: B79.1, U11.3
unnamed: B79.2, R61.2
unnamed: B81.2, C54.1, C57.1, DB4.1, L11.2
unnamed: B82.1, RF3.1
unnamed: B83.1, C87.1, T2.1
unnamed: B83.2, U7.38
unnamed: B84.1, C87.2, T2.3
unnamed: B84.2, U7.37
unnamed: B85.1, U7.42
unnamed: B86.1, B87.1, C60.1, C61.1, C62.1, FB17.1, U7.35, U7.40
unnamed: B88.1, C63.1, C64.1, FB18.2, U7.43
unnamed: B89.1, C65.1, C66.1, FB19.2, U7.58
unnamed: B90.1, B91.1, B92.1, C67.1, C68.1, C69.1, C70.1, FB20.1, U7.17, U7.60, U7.64
unnamed: B93.1, R108.1, R109.2, U13.3
unnamed: B95.1, R111.1, R112.2, U13.2
unnamed: B97.1, C84.1, C148.1, D6.1, Q3.3, R93.2, T3.1
unnamed: B97.2, R92.1
unnamed: B98.1, K2.8
unnamed: B98.2, T3.5
unnamed: B99.1, J31.1, L33.1, R92.2
unnamed: B99.2, R94.1, R98.2
unnamed: B100.2, B101.2, B102.2, B103.2, C85.2, C144.1, C145.1, C146.1, C147.1, R93.1, R96.2, R123.2, T3.2, U14.5
unnamed: B105.1, C84.2, C149.1, D7.1, Q4.3, R96.1, T3.3
unnamed: B105.2, R99.1
unnamed: B106.1, J32.1, L34.1, R99.2
unnamed: B106.2, R98.1, R100.1
unnamed: B109.1, U19.4
unnamed: B112.1, DB22.3
unnamed: B112.2, C11.1, R9.1, R18.2, U2.90
unnamed: B62.1, B63.1, B113.1, C44.1, FB13.1, U6.5, U6.10, U6.15
unnamed: B114.1, C12.1, FB26.1, U6.22
unnamed: B115.1, FB13.2, R10.2
unnamed: B116.1, U17.4
unnamed: B117.1, R114.1, R115.2, U13.1
unnamed: B118.1, DB19.1, Q6.2, U18.12
unnamed: B121.1, Q7.2, TP3.1
unnamed: C13.2, R11.2, R12.1, U3.3
unnamed: C19.2, R14.2, R15.1, U16.3
unnamed: C27.2, R19.2, R46.1, U8.3
unnamed: C35.1, J1.1, R29.1, U4.42
unnamed: C36.1, U4.46, X1.2
unnamed: C37.1, U4.45, X1.1
unnamed: C47.1, R117.1, R120.2, U2.25
unnamed: C49.1, DB3.4, L4.1, R50.1, U7.52
unnamed: C49.2, DB3.3, L7.2, R64.2, U7.51
unnamed: C50.1, L4.2, L5.1, R57.2
unnamed: C50.2, L7.1, L8.2, R57.1
unnamed: C51.1, L5.2, L6.1, R58.2
unnamed: C51.2, L8.1, L9.2, R58.1
unnamed: C53.1, C54.2, C56.1, L10.2, L11.1
unnamed: C53.2, C55.1, D1.1, DB16.1, J15.2, J16.1, L10.1
unnamed: C58.1, CL4.1, J22.2, U7.57, X3.2
unnamed: C59.1, U7.56, X3.1
unnamed: C71.1, R75.1, R77.1, U2.77
unnamed: C72.1, R76.1, R78.1, U2.80
unnamed: C73.1, R79.1, R81.1, U2.83
unnamed: C74.1, R80.1, R82.1, U2.85
unnamed: C75.1, R83.1, R85.1, U2.86
unnamed: C76.1, R84.1, R86.1, U2.87
unnamed: C77.1, R17.1, R87.1, R89.1, U2.88
unnamed: C78.1, R17.2, R88.1, R90.1, U2.89
unnamed: C79.1, R118.1, R121.2, U2.24
unnamed: C80.1, R119.1, R122.2, U2.23
unnamed: C85.1, R60.2
unnamed: C86.1, F1.2, Q1.3
unnamed: CL2.1, R45.1
unnamed: CN1.1, R4.1, U2.16
unnamed: CN1.3, U2.20
unnamed: CN1.5, R2.1, U2.18
unnamed: CN1.9, R3.1, U2.15
unnamed: CN2.1, D12.1, DB26.1, F1.1
unnamed: CN3.2, U4.8
unnamed: CN3.3, U4.7
unnamed: CN3.4, U4.6
unnamed: CN3.5, U4.5
unnamed: CN3.8, U4.11
unnamed: CN3.9, U4.10
unnamed: CN3.10, U4.3
unnamed: CN3.11, U4.2
unnamed: CN3.13, R32.1, R131.2, U4.15
unnamed: CN3.14, R30.1, R133.1
unnamed: CN3.16, R31.1, R134.1
unnamed: CN3.17, R33.1, R132.2, U4.17
unnamed: CN4.2, D8.2, R77.2
unnamed: CN4.3, D8.1, R78.2
unnamed: CN4.4, CN4.5, J13.2, J14.2
unnamed: CN4.6, D9.2, R81.2
unnamed: CN4.7, D9.1, R82.2
unnamed: CN5.2, D13.2, R85.2
unnamed: CN5.3, D13.1, R86.2
unnamed: CN5.4, CN5.5, J17.2, J18.2
unnamed: CN5.6, D14.2, R89.2
unnamed: CN5.7, D14.1, R90.2
unnamed: CN6.2, D2.1, U2.98
unnamed: CN6.3, D3.1, U2.100
unnamed: CN6.6, D5.1, U2.101
unnamed: CN6.7, D4.1, U2.99
unnamed: CN8.1, R120.1
unnamed: CN9.1, R121.1
unnamed: CN10.1, R122.1
unnamed: CN11.1, Q5.3
unnamed: D2.2, R71.1
unnamed: D3.2, R72.1
unnamed: D4.2, R73.1
unnamed: D5.2, R74.1
unnamed: D10.1, R103.2, U18.7
unnamed: D10.2, R113.1, U18.6
unnamed: D11.1, R114.2, U18.1
unnamed: D11.2, R116.1, U18.2
unnamed: DB5.1, J23.2, U2.72
unnamed: DB6.1, J8.1, U7.46
unnamed: DB6.2, J7.1, U7.50
unnamed: DB8.1, R13.2, U2.44
unnamed: DB11.1, R16.2, U2.46
unnamed: DB17.2, R106.1, U2.33, U13.5
unnamed: DB17.3, R107.1, U2.32, U13.6
unnamed: DB21.1, R54.1, T1.1
unnamed: DB24.1, U2.76
unnamed: DB25.1, R61.1, T1.2
unnamed: FB14.2, U2.11
unnamed: FB15.1, U2.39
unnamed: FB15.2, R124.2, U19.3
unnamed: FB16.1, U2.43
unnamed: FB16.2, U8.2
unnamed: FB21.1, U2.42
unnamed: FB21.2, R130.2, U12.5
unnamed: J1.2, U2.49
unnamed: J2.2, R13.1, U3.5
unnamed: J4.1, R36.2, R38.1, U5.1, X2.1
unnamed: J4.2, U6.3
unnamed: J7.2, U7.49
unnamed: J8.2, U7.45
unnamed: J9.2, U7.54
unnamed: J10.2, U7.62
unnamed: J11.2, R16.1, U16.5
unnamed: J12.1, J15.1, T2.5
unnamed: J16.2, J21.2, T2.4
unnamed: J19.2, U8.5
unnamed: J5.2, J23.1
unnamed: J28.1, R108.2, U18.8
unnamed: J28.2, R110.1, U18.9
unnamed: J30.1, R111.2, U18.14
unnamed: J30.2, R105.1, U18.13
unnamed: K2.9, RF2.1
unnamed: L1.1, U3.7
unnamed: L2.1, U16.7
unnamed: L3.1, U8.7
unnamed: L33.2, Q3.1
unnamed: L34.2, Q4.1
unnamed: Q2.1, R126.2, TP1.1, U2.7
unnamed: Q5.1, R125.2, TP4.1, U2.28
unnamed: R1.1, U1.2
unnamed: R1.2, U2.13
unnamed: R5.1, U2.92
unnamed: R6.1, U2.14
unnamed: R7.1, U2.9
unnamed: R20.2, U4.38
unnamed: R25.2, U2.54, U4.33
unnamed: R26.2, U2.50, U4.37
unnamed: R27.1, U2.52, U4.41
unnamed: R28.1, U2.53, U4.35
unnamed: R34.1, U4.48
unnamed: R35.2, R37.1, U5.6
unnamed: R39.1, R40.1, U6.1
unnamed: R41.2, U6.24
unnamed: R42.2, U6.20
unnamed: R45.2, U6.17
unnamed: R51.1, U9.3
unnamed: R52.2, R56.1, U9.1
unnamed: R55.2, R56.2, U9.2
unnamed: R59.1, R62.2, U9.7
unnamed: R63.1, U9.5
unnamed: R69.2, U7.41
unnamed: R91.2, R102.2, U12.4
unnamed: R47.1, R128.2, U15.5
unnamed: R66.1, R129.2, U15.8
unnamed: R135.1, U2.136, U7.53
unnamed: RF1.1, T1.4
unnamed: TP2.1, U2.55
unnamed: TP5.1, U7.21
unnamed: TP6.1, U7.61
unnamed: TP7.1, U2.129
unnamed: TP8.1, U2.128
unnamed: TP9.1, U2.127
unnamed: U1.1, U2.8
unnamed: U1.5, U2.6
unnamed: U1.6, U2.12
unnamed: U2.10, U7.1
unnamed: U2.51, U4.36
unnamed: U2.65, U4.25
unnamed: U2.66, U4.24
unnamed: U2.105, U7.24
unnamed: U2.106, U7.23
unnamed: U2.110, U7.22
unnamed: U2.111, U7.20
unnamed: U2.112, U7.16
unnamed: U2.113, U7.15
unnamed: U2.114, U7.14
unnamed: U2.115, U7.13
unnamed: U2.119, U7.30
unnamed: U2.120, U7.12
unnamed: U2.121, U7.11
unnamed: U2.125, U7.10
unnamed: U2.126, U7.19
unnamed: U2.132, U7.9
unnamed: U2.133, U7.8
unnamed: U2.135, U7.7
unnamed: U2.137, U7.6
unnamed: U2.141, U7.5
unnamed: U2.142, U7.4
unnamed: U2.143, U7.3
unnamed: U2.144, U7.2
PATRRX: B81.1, B82.2, K2.10
RFFE_CLK: J22.1, R42.1
SCL2: C82.1, CN7.3, R48.1, U2.31, U15.2
SDA2: C83.1, CN7.2, R53.1, U2.30, U15.3
TXPAn: B76.2, DB23.1, R97.1, R100.2
TXPAp: B69.2, DB20.1, R94.2, R97.2
VSUP: C17.1, C18.1, C23.1, C24.1, C33.1, C34.1, C46.1, C89.1, DB7.2, DB10.1, DB27.1, J6.1, Q1.2, U3.1, U3.2, U3.6, U8.1, U8.6, U12.8, U16.1, U16.2, U16.6, U19.1
Veth: B30.1, B31.1, B32.1, B33.1, B51.1, B52.1, B53.1, FB29.2, FB30.2, R20.1, R21.1, R22.1, R23.1, R24.1, R25.1, R26.1, R27.2, R28.2, R29.2, R30.2, R31.2, U2.40, U2.47, U2.56, U2.62, U4.16, U4.34, U4.40
Vipa: U14.6, U18.10
Vlvds: B29.1, FB27.2, FB28.2, J13.1, J17.1, R75.2, R76.2, R79.2, R80.2, R83.2, R84.2, R87.2, R88.2, U2.81
