ji1udd/Hermes-Lite2/compact-trx/powercontrol/PowerControl.kicad_pcb

## KiCad design compact-trx/powercontrol/PowerControl.kicad_pcb (2017-06-15)

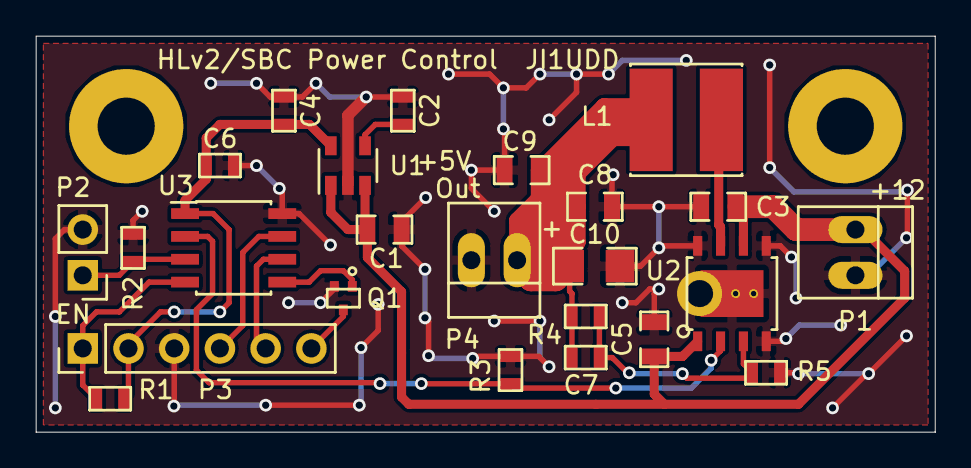
[picture p80: board PowerControl.kicad_pcb from above]

Board: 2 copper layers, 49.9 x 22.0 mm, 26 parts (0 on the bottom side), 14 nets.

Parts:
C1: 1uF/25V; SMD-0805
C2: 0.01uF; SMD-0603
C3: 10uF/25V; SMD-0805
C4: 2.2uF/10V; SMD-0603
C5: 4.7uF/25V; SMD-0805
C6: 0.1uF; SMD-0603
C7: 4.7nF; SMD-0603
C8, C9: 22uF/6.3V; SMD-0805
C10: 100uF/6.3V; SMD-1206
L1: 3.3uH; GENERICPSL
MH: VAL**; MH
MH#2: VAL**; MH
P1, P4: CONN_01X02; PINHEAD1-2
P2: CONN_01X02; Pin_Header_Straight_1x02_Pitch2.54mm
P3: CONN_01X06; Pin_Header_Straight_1x06_Pitch2.54mm
Q1: DTC144E; SOT416
R1, R2, R3, R5: 10k; SMD-0603
R4: 53.6k; SMD-0603
U1: TAR5SB33; SOT-23-5
U2: ST1S10
U3: PIC12F1822-E/SN; SOIC-8_3.9x4.9mm_Pitch1.27mm

Connections:
GND: C1.2, C2.2, C3.2, C4.2, C5.2, C6.1, C8.2, C9.2, C10.2, P1.2, P2.2, P3.3, P4.2, Q1.2, R2.2, R3.2, R5.2, U1.2, U2.4, U2.5, U2.8, U2.9, U3.8
unnamed: C1.1, C3.1, C5.1, P1.1, U1.1, U1.3, U2.1, U2.6
unnamed: C2.1, U1.4
unnamed: C4.1, C6.2, P3.2, R1.1, U1.5, U3.1
unnamed: C7.2, R4.2, R5.1, U2.3
unnamed: C7.1, C8.1, C9.1, C10.1, L1.2, P4.1, R4.1
unnamed: L1.1, U2.7
unnamed: P2.1, R2.1, U3.3
unnamed: P3.1, R1.2, U3.4
unnamed: P3.4, U3.7
unnamed: P3.5, U3.6
unnamed: P3.6, Q1.3
unnamed: Q1.1, U3.5
unnamed: R3.1, U2.2, U3.2
