ji1udd/Hermes-Lite2/(commit log)

2017-06-15 added CompactTRX branch
    [BOM_PwrCtrl.xls, PowerControl.kicad_pcb, PowerControl.sch]
2017-08-17 1st release ; CW Keyer I/F - AK4951 board and Tx Rx Filter test board documents.
    [AudioCodec.sch, BOM_AK4951_Codec_rev2.xls, BOM_FILTER.xls, hermeslite.kicad_pcb, hermeslite.sch, rx-filter.sch, tx-filter.sch]
2017-11-19 Supported Tx/Rx filter and 100base-TX
2017-12-17 Added Temperature and Ammeter to piHPSDR analog meter.
2018-01-07 Added I/F board documents
2018-01-13 latest TRX schematic
2018-01-22 Added ExtAMP / ATU Interface schematic
2018-02-04 Updated TRX schematic (v1.20)
2019-07-12 added documents for AK4951 audio codec board
2019-09-09 Fixed low Rx sensitivity issue after transmit in CW mode
    [hermeslite.v]
2019-09-14 Fixed bug ( ADC1 overload indicator on PowerSDR doesn't work correctly )
    [hermeslite.v]
2019-09-15 Added PowerSDR setting document
2019-10-10 Improved straight key and added electronic bug key function
    [Keyer.v, KeyerWrapper.v, hermeslite.v]
2019-10-13 Fixed reg. swtching noise issue on 160m/80m bands.
    [hermeslite.v]
